marcosbuydid/dc-dc-power-supply/README.md

# Dual DC-DC Power Supply
This is an electronic proyect I started on July 2020 and finish on December 2023.
I began writing the application reports in the last months of 2023 and finish them on December 2024.

## Content
The design is modular, from 1 to 6, each one with a specific function.
In every module folder you will find the schematic and the application report among other files if needed.

## License
All files in this repository are licensed under the terms of the LICENSE file unless stated otherwise.

## Module Folders
Module 1 - Buck-Boost DC/DC Converter

Module 2 - 2 Channel Dual Voltage-Current Meter

Module 3 - Surge-Stopper

Module 4 - 2 Channel Soft-Start

Module 5 - Smart Fan Temperature Controller

Module 6 - Dual Mosfet On-Off Switch

## Copyright © 2020-2026 Marcos Buydid
