marcosbuydid/dc-dc-power-supply/DC:DC Power Supply Modules Connection Diagram.pdf

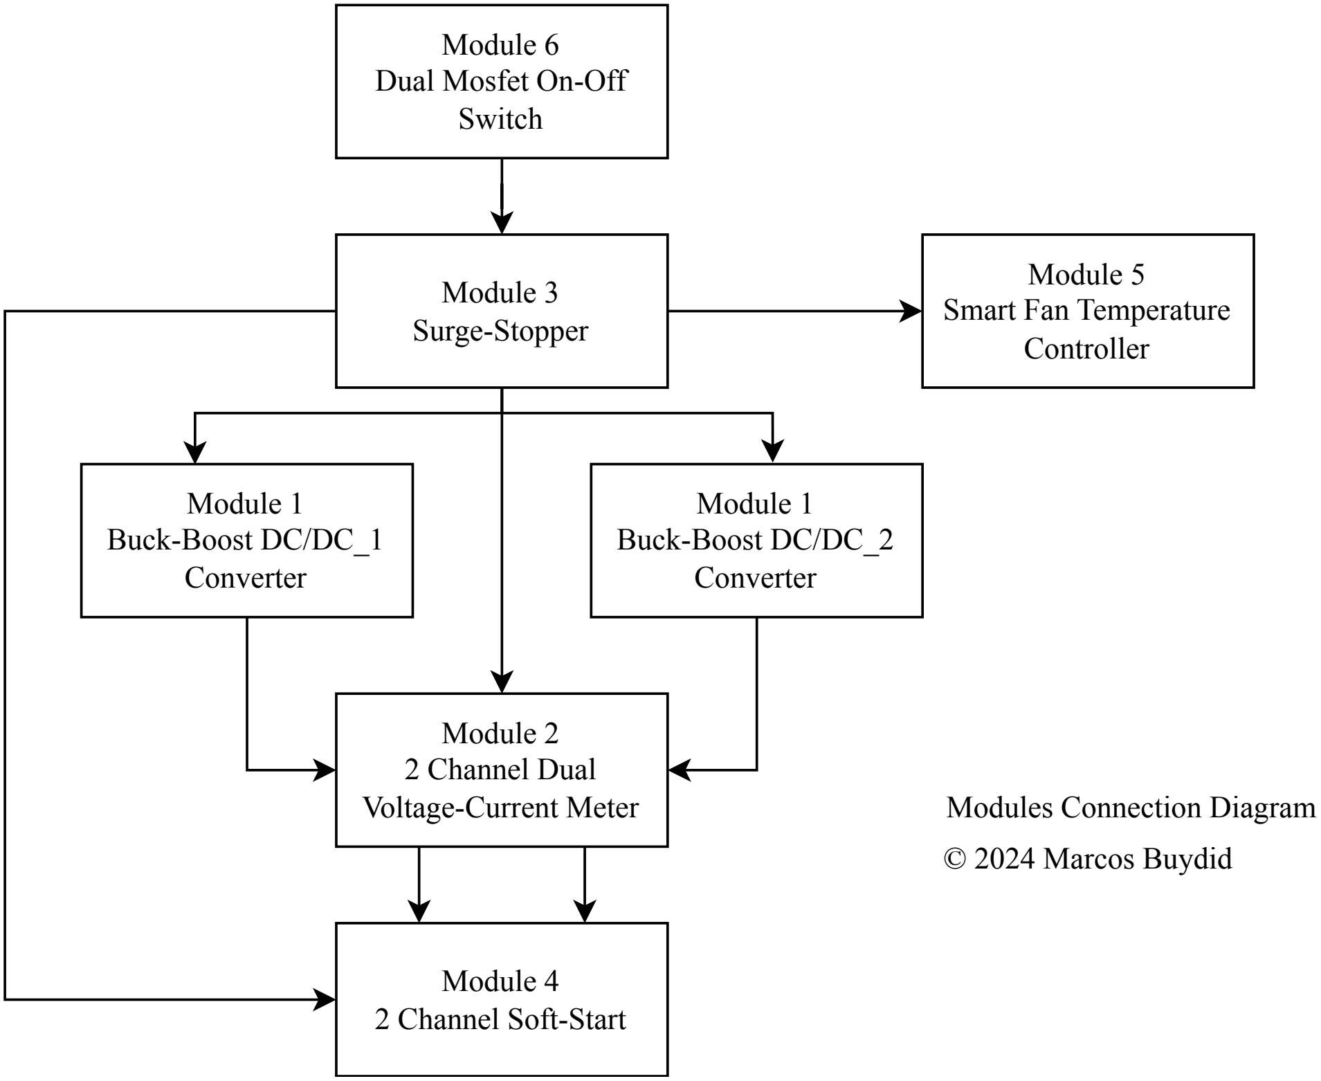
[picture p1: figure]
Module 6 Dual Mosfet On-Off Switch; Module 3 Surge-Stopper; Module 1 Buck-Boost DC/DC_1 Converter; Module 1 Buck-Boost DC/DC_2 Converter; Module 5 Smart Fan Temperature Controller; Module 2 2 Channel Dual Voltage-Current Meter; Module 4 2 Channel Soft-Start; Modules Connection Diagram; © 2024 Marcos Buydid
