marcosbuydid/dc-dc-power-supply/Module_2/2_channel_dual_voltage_current_meter_fw_v1.0.0_Release_Report.xlsx

Sheet: Summary
2 Channel Dual Voltage-Current Meter: firmware v1.0.0 release report
First production release. Compared against v0.3.0. Updated 28 Sep 2026 for the final release file (voltage calibration line, clearer names and comments, debug cycle number).
Release
Firmware file | 2_channel_dual_voltage_current_meter_fw_v1.0.0.ino (final)
Target | Arduino Nano (ATmega328P), Arduino AVR core
Tested binary | The final release file compiles to exactly the build every test suite ran on (production and debug)
Voltage calibration | displayed = measured x 0.99578 + 31 mV, rounded to 10 mV: 0.790-20.110 V, then OL
Verdict | Ready for release: no failures in any simulated test; bench voltage check agrees with a Fluke 15B+
Release condition | Release after the remaining Bench Test Plan checks pass
Simulated tests (v1.0.0)
Test cases | 102
Passed | 99
Failed | 0
Observations | 3 | Behavior kept from v0.3.0 on purpose; see Findings.
Unit tests (functions called directly on the chip)
Unit test cases | 234322
Mismatches against the models | 0 | Must be 0.
Parity with v0.3.0 (every ADC code 0-1023)
Voltage: identical | 595
Voltage: within 10 mV (calibration line) | 423 | The line replaces the 7 offset bands; mean difference 0.0 mV.
Voltage: -20 mV at the end of the old +30 mV band | 3 | 4.13-4.17 V: the old band over-corrected there.
Voltage: low range fixed (0.82, 0.84 V) | 2 | v0.3.0 showed 0.790 / 0.800 here and ran backwards.
Voltage: ADC full scale now OL | 1
Current: identical | 852
Current: +0.01 A (nearest step) | 58 | v1.0.0 picks the closer table value; v0.3.0 leaned to the lower one.
Current: gap bug fixed (2.49/2.50 A) | 2
Current: above 5.00 A now OL | 112
Unexplained differences | 0 | Must be 0.
Findings
Open: check on bench | 4
Open: recommendations | 6
Fixed in the final file | 4 | F-02, F-03 (calibration line), F-10 (parameter renamed) and F-11 (comments).
Stability (display changes in 1,500 noisy cycles)
v0.3.0 | 528
v1.0.0 | 4
Reduction | 99.2%
Voltage accuracy
Estimated spec | ±(0.1 % + 2 digits) | Error budget on the Voltage Accuracy sheet; 1 digit = 10 mV.
Fluke 15B+ points inside its tolerance | 10 of 10
Largest difference where the Fluke can decide (mV) | #VALUE! | Below 4 V; above 4 V a better reference is needed (F-13, BT-49).
Keysight E36312A vs this meter at 12 V | 0.24x | About 4x more accurate; Siglent SPD3303X-E is about 2.5x less accurate.
Memory and timing (v1.0.0 production build)
Flash | 9358 | bytes
Free RAM at peak | 1565 | bytes
Free RAM at peak, v0.3.0 | 596 | bytes
Measurement work per 560 ms cycle | 42.7 | ms (typical)
Worst-case measurement work | 56.6 | ms (samples in worst order for sorting)
Bench test plan (fill in on the hardware)
Passed | 0
Failed | 0
Not done yet | 49
Before flashing a production unit
1. Confirm DEBUG_FLAG is 0 in the file you flash.
2. Check the board uploads with Processor "ATmega328P" (Optiboot). Old bootloader + watchdog can reset endlessly.
3. Keep VOLTAGE_CAL_GAIN 0.99578 and VOLTAGE_CAL_OFFSET_MV 31.0 unless BT-49 with a better reference shows otherwise.
4. Run the Bench Test Plan, including BT-43 (outlier rejection on your real load) and BT-49 (voltage 5-20 V).
Sheets in this workbook
Changes | Every modification from v0.3.0 to v1.0.0
Enhancements | Improvements with measured numbers
Test Cases | 102 test cases with v0.3.0 and v1.0.0 results
Unit Tests | Function-by-function results
ADC Parity | All 1,024 ADC codes, voltage, current, LED and LCD row
Stability Tests | Noise, dropout and ramp tests; outlier rejection limits
LCD Scenarios | Exact LCD rows in over range, LED, alert and crosstalk events
Findings | Open and closed findings for v1.0.0
Memory & Timing | Flash, RAM, stack, cycle time, watchdog margin
Bench Test Plan | Hardware checks to fill in
Voltage Accuracy | Fluke 15B+ bench check, error budget, comparison with commercial supplies
Method | How everything was tested

Sheet: Changes
Modifications from v0.3.0 to v1.0.0
v0.3.0 = 2_channel_dual_voltage_current_meter_fw_v0.3.0.ino. v1.0.0 = 2_channel_dual_voltage_current_meter_fw_v1.0.0.ino.
ID | Area | Type | v0.3.0 behavior | v1.0.0 behavior | User visible | Verified by
CH-01 | Current | Bug fix | Linear search in two halves; 2.219-2.228 V (2.49-2.50 A) fell in neither half | Binary search over the whole table | Yes | C-03
CH-02 | Current | Behavior change | Picks the lower step unless the reading is > 5 mV above it | Picks the truly nearest step (58 of 912 codes show +0.01 A) | Yes | C-02, C-05
CH-03 | Current | Bug fix | Above 5.00 A returns 999.23: display "999.2A0", LED off | "OL" in the current field, LED on | Yes | C-04, L-03
CH-04 | Voltage | Enhancement | ADC full scale shows 20.130 V | "OL" in the voltage field | Yes | V-02
CH-05 | ADC | Enhancement | 1 sample per reading | 64 samples per channel (16 for temperature), fractional average | Yes (stability) | V-06 to V-08, C-07, C-08
CH-06 | ADC | Enhancement | None | Outlier rejection: samples > 8 counts from the median are ignored | Yes (dropouts) | A-07 to A-09
CH-07 | ADC | Enhancement | 1 settling read after a channel switch | 2 settling reads | No | A-03, A-06
CH-08 | ADC | Enhancement | Fixed sample timing | 0-7 us random jitter between samples | No | A-04
CH-09 | Display | Enhancement | None | Hysteresis: 3 mV on voltage steps, 1.5 mV on current steps | Yes (no flicker) | V-07, V-09, C-07
CH-10 | Display | Enhancement | n/a | Hysteresis cleared at startup, over range, below 0.790 V and on alert changes | No | T-05
CH-11 | Temperature | Enhancement | Alert on and off at 0.680 V (toggles near threshold) | On at 0.680 V, off below 0.670 V | Yes | T-02, T-03
CH-12 | Display | Bug fix | Alert screen cleared every cycle (flicker); leftovers "-T"/"LE" after the alert | Alert drawn once; screen cleared once on exit | Yes | D-05, D-06
CH-13 | Display | Behavior change | Alert label "IC6-TEMP" | Alert label "VREF-TEMP" | Yes | D-05
CH-14 | Display | Bug fix | Fields printed in pieces; stale "0" in column 15 after an error value | Each row built as a full 16-character line | Yes | D-01, D-02
CH-15 | Display | Behavior change | 4 decimals below 10 V ("5.0300V"), 3 above ("12.030V") | Always 3 decimals, right-aligned (" 5.030V") | Yes | D-04
CH-16 | Timing | Enhancement | delay(10) + delay(550): real period about 573 ms | millis() scheduler: exactly 560 ms, rollover safe | No | S-01 to S-03
CH-17 | Reliability | Enhancement | None | 2 s watchdog; reset cause captured; watchdog disabled early after a reset | Yes (splash message) | W-01, W-02
CH-18 | Startup | Enhancement | Analog pins INPUT only | DIDR0 buffers off, unused pins pulled up, D13 and LEDs LOW, reference selected first | No | I-01 to I-06
CH-19 | Startup | Bug fix | pinMode(A6) outside the pin tables | Removed | No | I-07
CH-20 | Memory | Enhancement | Lookup table in RAM (1,319 B static RAM) | Table in flash (PROGMEM), strings in flash (F()): 273 B static RAM | No | M-01, M-02
CH-21 | Serial | Enhancement | Serial.begin(9600) with no output | No serial in production; debug build at 115200 with per-cycle diagnostics | No | G-01
CH-22 | Code | Refactor | Globals per channel, magic numbers, 999.23 sentinel | Channel struct, Reading/ReadingStatus, named constexpr constants, prototypes, static_asserts | No | B-01, B-04
CH-23 | Startup | Refactor | lcd.begin() called twice | Called once; splash text unchanged | No | I-08
CH-24 | Voltage | Calibration | 7 offset bands (+30 to -40 mV) added after truncating to 10 mV; special low range (0.790 / 0.810 V below 0.800 V) | One calibration line: displayed = measured x 0.99578 + 31 mV (fit of the same bands), rounded to the nearest 10 mV; 0.000 below 0.790 V. Constants VOLTAGE_CAL_GAIN / VOLTAGE_CAL_OFFSET_MV (1.0 / 0.0 = no compensation). 410 B less flash. | Yes (within 10 mV; no backwards steps) | V-01, V-04, V-05, V-09, V-11, V-12
CH-25 | Code | Refactor | Names: captureResetFlags, calculateChannelMeasurements, showTemperatureAlert, REFRESH_MEASUREMENT_PERIOD_MS, CURRENT_TO_VOLTAGE_TABLE_LAST, voltageSenseMv (parameter), temperatureVoltage | captureResetFlagsAndDisableWatchdog, calculateAndDisplayChannelMeasurements, showVRefTemperatureAlert, MEASUREMENT_PERIOD_MS, CURRENT_TO_VOLTAGE_TABLE_LAST_INDEX, currentSenseMv, vRefTemperatureVoltage. Comments reworded (lines 18, 159-161, 213, 465, 569, 591-593). Production binary unchanged | No | R-03, B-05
CH-26 | Serial | Enhancement | Debug lines without a cycle reference | Debug build: every line starts with "#n" (debugCycleCount, +1 per 560 ms cycle, restarts at 1 after a reset). Debug build only: +0.2 ms per cycle, +118 B flash, +4 B RAM | Debug only | G-01, B-02

Sheet: Enhancements
What v1.0.0 improves, with measured evidence
All figures are measured in the simulation runs (see Method). Improvement columns are formulas.
Enhancement | Metric | v0.3.0 | v1.0.0 | Improvement | Evidence
Stable voltage display | Display changes, 10 mV boundary (ADC 611.40), 300 cycles | 158 | 3 | 98.10126582% fewer | V-07
Stable voltage display | Display changes inside a step (ADC 611.15), 300 cycles | 188 | 0 | 100% fewer | V-08
Stable current display | Display changes, 0.01 A boundary, 300 cycles | 142 | 1 | 99.29577465% fewer | C-07
Stable current display | Display changes inside a step, 300 cycles | 30 | 0 | 100% fewer | C-08
Dropout immunity | Cycles showing 0.02 A with 2% dropouts, of 300 | 5 | 0 | 100% fewer | A-07
Voltage resolution | Distinct displayed voltages reachable | 984 | 1934 | 2.0x | V-06, V-11; fine sweep
Correct current in 2.49-2.50 A | ADC codes showing an error value | 2 | 0 | 100% fewer | C-03
Clear over-range display | Codes showing garbage "999.2A0" | 112 | 0 | 100% fewer | C-04
Clean LCD rows | Sweep steps with a leftover character | 569 | 0 | 100% fewer | D-01
No alert flicker | Screen clears per alert cycle | 1 | 0 | 100% fewer | D-05
Alert hysteresis | Alert state changes while hovering 0.684/0.679 V after the alert is on (3 cycles) | 3 | 0 | 100% fewer | T-03
Crosstalk margin | Contaminated reads tolerated after a channel switch | 1 | 2 | 2.0x | A-05, A-06
RAM headroom | Free RAM at peak stack (bytes) | 596 | 1565 | 2.6x | M-02
Timing precision | Measurement period (ms) | 573 | 560 | Exactly 560 ms (was 573 ms) | S-01, S-03
Self-recovery | Time to recover from a firmware hang (ms) | Never (hangs) | 2029 | Recovers automatically | W-01
Smooth voltage calibration | Places where a rising voltage makes the display step back (fine sweep) | 2 | 0 | 100% fewer | V-09, F-02, F-03
Improvement = 1 - v1.0.0 / v0.3.0 for "fewer" rows, v1.0.0 / v0.3.0 for "x" rows.

Sheet: Test Cases
Test cases and results
Results for v1.0.0 and v0.3.0. Source: simulated ATmega328P test runs (see Method).
ID | Group | Test | Stimulus | Expected (v1.0.0) | v0.3.0 result | v1.0.0 result | Status | Method
B-01 | Build | Production build compiles (DEBUG_FLAG 0) | avr-gcc 7.3.0, strict C++ (no IDE auto-prototypes), -Wall -Wextra | No errors, no warnings | Compiles only with IDE auto-prototypes | No errors, no warnings. 9,358 B flash, 273 B SRAM | PASS | Compiler
B-02 | Build | Debug build compiles (DEBUG_FLAG 1) | Same, DEBUG_FLAG 1 | No errors, no warnings | n/a (no debug mode) | No errors, no warnings. 10,476 B flash, 291 B SRAM (cycle number added to debug output) | PASS | Compiler
B-03 | Build | Release file is set to production | Check DEBUG_FLAG in the file to be flashed | DEBUG_FLAG 0 | n/a | DEBUG_FLAG 0 | PASS | Code review
B-04 | Build | Compile-time checks | static_assert: table size 501, alert OFF < ON, sample counts <= 64 | All hold | None present | All hold | PASS | Compiler
I-01 | Startup | External reference selected before first ADC read | Record order of analogReference / analogRead | analogReference(EXTERNAL) before any analogRead | OK (set in setup, reads in loop) | OK (first line of setup) | PASS | Simulation
I-02 | Startup | Analog inputs A0-A3 configured | Record pinMode calls | INPUT, no pull-up | INPUT | INPUT | PASS | Simulation
I-03 | Startup | Digital input buffers off on A0-A3 | Read DIDR0 after setup | DIDR0 = 0x0F | DIDR0 = 0x00 | DIDR0 = 0x0F | PASS | Simulation
I-04 | Startup | LED pins D3/D5 | Record pinMode / digitalWrite | OUTPUT, LOW at start | OUTPUT (default LOW) | OUTPUT, explicitly LOW | PASS | Simulation
I-05 | Startup | Unused pins D2, D4, D6, A4, A5 | Record pinMode | INPUT_PULLUP (not floating) | Not configured (floating) | INPUT_PULLUP | PASS | Simulation
I-06 | Startup | On-board LED D13 | Record pinMode / digitalWrite | OUTPUT, LOW | Not configured | OUTPUT, LOW | PASS | Simulation
I-07 | Startup | No pinMode() on A6 (pin 20) | Record pinMode calls; inspect pin tables in the binary | Not called (A6 is analog-only, outside Arduino pin tables) | Called: reads past pin table (no effect in this build) | Not called | PASS | Simulation + binary inspection
I-08 | Startup | Splash screen | Capture LCD during the 2 s splash | "STARTING" / "PLEASE WAIT" | | STARTING | PLEASE WAIT | | | STARTING | PLEASE WAIT | | PASS | Simulation
I-09 | Startup | Splash after a watchdog reset | Force a hang, capture splash on reboot | "WATCHDOG RESET" on row 2 | n/a (no watchdog) | | STARTING | WATCHDOG RESET | | PASS | Simulation
A-01 | ADC | Conversions per measurement cycle | Count analogRead calls in one cycle | 282 = 18 temperature + 4 x 66 | 10 (2 per pin) | 282 (A6 18, A0-A3 66 each) | PASS | Simulation
A-02 | ADC | Channel read order | Record pin sequence | A6, A3, A2, A0, A1 (same as v0.3.0) | A6, A3, A2, A0, A1 | A6, A3, A2, A0, A1 | PASS | Simulation
A-03 | ADC | Settling reads after channel switch | Count discarded reads | 2 per switch | 1 per switch | 2 per switch | PASS | Simulation
A-04 | ADC | Sample jitter distribution | Histogram of delayMicroseconds() arguments over the full run | Uniform 0-7 us | n/a | 0-7 us, each value 12.5% (219,884-219,971 per bin) | PASS | Simulation
A-05 | ADC | Crosstalk: 1 contaminated read after switch | Model: first read after a switch returns previous channel value | Correct reading | Correct | Correct | PASS | Simulation (model)
A-06 | ADC | Crosstalk: 2 contaminated reads after switch | Model: first 2 reads return previous channel value | Correct reading | Wrong: shows 0.0000V / 0.000A | Correct: 17.700V / 0.720A | PASS | Simulation (model)
A-07 | ADC | Single-sample dropouts (original symptom) | 0.72 A, ±0.5 count noise, 2% of samples drop to 0.02 A, 300 cycles | Steady 0.720A | 0.02A shown in 5 of 300 cycles | 0.720A in all 300 cycles (with outlier rejection off, OUTLIER_LIMIT_COUNTS = 1023: 215 display changes, 0.65-0.72 A) | PASS | Simulation
A-08 | ADC | Outlier rejection disabled (limit 1023) | Full test run with OUTLIER_LIMIT_COUNTS = 1023 | Identical to a plain average of all samples | n/a | 6,473 of 6,473 rows identical to a plain-average build of the final file | PASS | Simulation
A-09 | ADC | Outlier rejection is neutral for normal signals | All sweeps, ramps, noise, OL, LED, temperature, crosstalk tests | Identical to plain average | n/a | All rows identical except the 300-cycle dropout test (A-07) | PASS | Simulation
V-01 | Voltage | Full ADC sweep, codes 0-1022, parity with v0.3.0 | Each code, fresh state, both channels | Within 10 mV of v0.3.0 except the intended fixes | Reference | 595 identical, 423 within ±10 mV (line instead of bands), 3 at -20 mV (4.13-4.17 V, end of the old +30 mV band), 2 low-range fixes (codes 40-41), 1 OL | PASS | Simulation
V-02 | Voltage | ADC full scale (code 1023) | Voltage ADC saturated | "OL" | 20.130V (not a real value) | OL | PASS | Simulation
V-03 | Voltage | Independent model check | Python float32 re-implementation of both algorithms (v0.3.0 offset bands, v1.0.0 calibration line) | Both firmwares match their model | Matches 1024/1024 | Matches 1023/1023 codes, plus all 51,151 points of a fine sweep (ADC 0-1023 in 0.02 steps) | PASS | Simulation + model
V-04 | Voltage | Low range near 0.790 V | Codes 0-45 | 0.000 below 0.790 V (after calibration), then only rising values | Codes 38-41: 0.000, 0.790, 0.790, 0.800; runs backwards at 0.800 V (F-02) | Codes 38-42: 0.000, 0.800, 0.820, 0.840, 0.860; always rising | PASS | Simulation
V-05 | Voltage | Calibration line | VOLTAGE_CAL_GAIN 0.99578, VOLTAGE_CAL_OFFSET_MV 31.0, whole range | Smooth correction: +27 mV at 1 V to -53 mV at 20 V, no band steps | 7 offset bands, +30 to -40 mV | Matches the model at every point. Versus v0.3.0: mean 0.0 mV, 99.7% of fine-sweep points within ±10 mV | PASS | Simulation
V-06 | Voltage | Resolution on a slow ramp | Codes 200-260 (3.9-5.1 V) in 0.1 steps, up and down | All 118 10 mV values | 59 changes (skips every other 10 mV value) | 117 changes (every 10 mV value, 3.960-5.130 V); never more than 10 mV from ideal | PASS | Simulation
V-07 | Voltage | Stability on a 10 mV boundary | ADC 611.40 (12.035 V after calibration, exactly on a step boundary), ±1 count noise, 300 cycles | Few display changes | 158 changes (12.01/12.03/12.05) | 3 changes (12.03/12.04) | PASS | Simulation
V-08 | Voltage | Stability inside a step | ADC 611.15 (12.030 V), ±1 count noise, 300 cycles | No display changes | 188 changes | 0 changes | PASS | Simulation
V-09 | Voltage | Hysteresis correctness | 2,886 ramp cycles (simulation), 40,922-step function ramp ADC 0-1023 up and down, 96,962 unit cases | Never more than 1 step from nearest value; never moves against the input | n/a | Max 1 step (0.01 V); 0 reversals anywhere (F-02 and F-03 closed) | PASS | Simulation + model
V-10 | Voltage | Channel 2 identical to channel 1 | Same input on both channels, all sweeps | Identical rows | Identical | Identical | PASS | Simulation
C-01 | Current | Full ADC sweep, parity with v0.3.0 | Codes 0-1023, fresh state | Same as v0.3.0 except intended fixes | Reference | 852 identical, 58 +0.01 A, 2 gap fixed, 112 OL | PASS | Simulation
C-02 | Current | Rounding to nearest 0.01 A step | 58 codes where v0.3.0 rounds down | Nearest table step | Lower step (5 mV rule) | Nearest step (+0.01 A vs v0.3.0) | PASS | Simulation + model
C-03 | Current | 2.49-2.50 A gap | Codes 455 and 456 | 2.490A and 2.500A | 999.2A0 (error value) | 2.490A and 2.500A | PASS | Simulation
C-04 | Current | Above 5.00 A | Codes 912-1023 | "OL" | 999.2A0 (garbage), LED off | OL, LED on | PASS | Simulation
C-05 | Current | Independent model check | Python nearest-step model | Match | n/a | 1024 of 1024 | PASS | Model
C-06 | Current | Slow ramp 0.49-0.78 A | Codes 100-160 in 0.1 steps, up and down | Monotonic, max 1 step from nearest | Monotonic, max 0.01 A | Monotonic, max 0.01 A | PASS | Simulation
C-07 | Current | Stability on a 0.01 A boundary | 0.71/0.72 A boundary, ±1 count noise, 300 cycles | Few display changes | 142 changes | 1 change | PASS | Simulation
C-08 | Current | Stability inside a step | 0.72 A, ±1 count noise, 300 cycles | No display changes | 30 changes (0.72/0.73) | 0 changes | PASS | Simulation
C-09 | Current | Channel 2 identical to channel 1 | Same input on both channels | Identical rows | Identical | Identical | PASS | Simulation
D-01 | Display | No leftover characters in normal rows | Current sweep 0-1023 | Column 15 always blank | "0" left in column 15 in 569 of 1024 steps | Blank in 1024 of 1024 | PASS | Simulation
D-02 | Display | Return from current over range | OL then 0.72 A | "0.720A" clean | "0.720A0" | "0.720A" | PASS | Simulation
D-03 | Display | Voltage over range | ADC 1023 | "OL" in voltage field | "20.130V" | " OL" | PASS | Simulation
D-04 | Display | Row format | All tests | 16 characters, 3 decimals | "5.0300V" below 10 V, "12.030V" above | " 5.030V" / "12.030V", always 3 decimals | PASS | Simulation
D-05 | Display | Temperature alert screen | Temperature 0.684 V | Alert text, drawn once | "IC6-TEMP" / "ALERT", screen cleared every cycle (flicker) | "VREF-TEMP" (column 4, as v0.3.0) / "ALERT", cleared once on entry | PASS | Simulation
D-06 | Display | Screen after the alert ends | Temperature back to 0.645 V | Clean measurement rows | Leftover "-T" and "LE" from alert text | Clean (cleared once on exit) | PASS | Simulation
L-01 | LED | LED at 0.00 A | Current code 0 and 1 | Off | Off | Off | PASS | Simulation
L-02 | LED | LED at 0.01-5.00 A | Current codes 2-911 | On | On | On | PASS | Simulation
L-03 | LED | LED above 5.00 A | Current codes 912-1023 | On (current is flowing) | Off | On | PASS | Simulation
L-04 | LED | LEDs during temperature alert | Alert active | Documented behavior | Keep last state | Keep last state (unchanged from v0.3.0) | OBSERVATION | Simulation
T-01 | Temperature | Alert turns on | Temperature code 140 (0.684 V) | Alert on at >= 0.680 V | On | On | PASS | Simulation
T-02 | Temperature | Alert hysteresis | Codes 139, 138 after alert | Stays on until < 0.670 V | Turns off at 139 (0.679 V) | Stays on at 139/138; off at 137 (0.669 V) | PASS | Simulation
T-03 | Temperature | Hovering at the threshold | Alternating codes 140/139 | No toggling | Toggles every cycle | Stays in alert | PASS | Simulation
T-04 | Temperature | Measurements pause during alert | Count ADC reads during alert | Only temperature is read | Channels read but not shown | 18 reads (temperature only) | PASS | Simulation
T-05 | Temperature | Hysteresis state reset after alert | Alert on then off | Previous steps cleared | n/a | Cleared (NO_STEP) | PASS | Code review + simulation
S-01 | Timing | Refresh period | loop() at +100, +559, +560 ms | Measure only at +560 ms | n/a (delay based) | 0, 0, 282 reads | PASS | Simulation
S-02 | Timing | millis() rollover (49.7 days) | Last measurement 0xFFFFFE00, now 0xFFFFFFF0 then 0x00000030 | No measurement at 496 ms, measurement at 560 ms | n/a | Correct | PASS | Simulation
S-03 | Timing | Measurement cycle work time | Real firmware, real ADC timing and LCD library | Well under 560 ms | 13 ms work + 560 ms delays = 573 ms period | 42.7 ms work, 560 ms period (debug build 47.4 ms) | PASS | Simulation (real firmware)
W-01 | Watchdog | Recovery from a firmware hang | Infinite loop inside analogRead(A2) | Reset within ~2 s, normal operation after | n/a (hangs forever) | Reset after 2,029 ms; reset flags 0x08; normal readings after reboot | PASS | Simulation
W-02 | Watchdog | No spurious resets | Full test run, about 6,500 cycles | No unexpected reset | n/a | None | PASS | Simulation
M-01 | Memory | Static RAM | Compiler report | Low | 1,319 B (64%) | 273 B (13%) | PASS | Compiler
M-02 | Memory | Peak stack | RAM painting, real firmware | Enough free RAM | 133 B, 596 B free | 210 B, 1,565 B free | PASS | Simulation (real firmware)
B-05 | Build | Release file compiles to the tested binary | Compare compiled binaries byte by byte | Identical binaries | n/a | Production binary of the final file (with renames and comment fixes) is byte-for-byte identical to the tested release (9,358 B). Debug binary identical to the build every debug test ran on | PASS | Compiler
B-06 | Build | Extra compiler warnings | -Wshadow -Wpedantic -Wcast-qual -Wdouble-promotion -Wundef -Wuninitialized -Wlogical-op -Wduplicated-cond | No real issues | n/a | Only -Wdouble-promotion on fabs() (lines 500, 541): double = float on AVR, no effect (F-09) | PASS | Compiler
B-07 | Build | Static analysis | cppcheck 2.13 --enable=all --inconclusive, debug build | No defects | n/a | No defects (only "setup/loop/captureResetFlagsAndDisableWatchdog never used": called by the Arduino core and startup code) | PASS | Static analysis
B-08 | Build | Compile-time checks block bad settings | Break each check on purpose: 65 samples, 0 samples, alert OFF > ON, table with 500 entries | Build fails with a clear message | n/a | All 4 builds fail with their own message ("Too many samples", "At least one sample", ...) | PASS | Compiler
R-01 | Regression | Full system bench on the final release file | Same 6,473-row run, compared with the previous v1.0.0 build (7-band voltage table) | Only the voltage values change, as intended | n/a | Current, LEDs, screen clears and ADC read counts identical in all 6,473 rows. Voltage differs only where the calibration line changes it; all 2,048 sweep values match the model. Alert text at column 4, as v0.3.0 | PASS | Simulation
R-02 | Regression | Unit, edge and timing suites on the final file | Unit (125,583 lines), edge (3,445 lines), fine voltage sweep and ramps, timing on the real firmware | All pass | n/a | 0 mismatches in every suite; timing 42.7 ms per cycle, peak stack 210 B | PASS | Simulation
U-01 | Unit: averaging | All samples equal | All 0, all 1023, all 500 | Exact value | n/a | 0.0000, 1023.0000, 500.0000 | PASS | Unit test
U-02 | Unit: averaging | Sorting | Ascending 0-63 and descending 63-0 | Same result | n/a | 32.0000 both | PASS | Unit test
U-03 | Unit: averaging | Dropouts and spikes rejected | 62x131 + 2x4; 60x131 + 4x1023 | 131 | n/a | 131.0000 both | PASS | Unit test
U-04 | Unit: averaging | Rejection limit exactly 8 counts | 60x500 + 2x508 + 2x509; 60x500 + 2x492 + 2x491 | 508/492 kept, 509/491 dropped | n/a | 500.2581 and 499.7420 (exact expected values) | PASS | Unit test
U-05 | Unit: averaging | Two levels (load step inside the window) | 32x100 + 32x200; 33x100 + 31x200 | Majority level | n/a | 200.0000 and 100.0000 | PASS | Unit test
U-06 | Unit: averaging | Normal noise equals plain mean | 64 random samples 128-135 | Plain mean 131.65625 | n/a | 131.6562 | PASS | Unit test
U-07 | Unit: averaging | Temperature (16 samples) | 14x139 + 2x0 | 139 | n/a | 139.0000, 18 reads | PASS | Unit test
U-08 | Unit: averaging | Sample count above 64 is capped | Request 100 samples | 64 used, no array overflow | n/a | 300.0000, 66 reads (2 settling + 64) | PASS | Unit test
U-09 | Unit: averaging | Sample count 1 and 0 | Request 1 and 0 samples | 1: the sample; 0: not used by firmware | n/a | 1: 777.0000. 0 is blocked at compile time (static_assert "At least one sample") | PASS | Unit test
U-10 | Unit: voltage | computeVoltage() at every step boundary | Steps 79-2017 (0.785-20.165 V) x 10 offsets (-3.1 to +5 mV) x 5 previous states, plus OL and 0.790 V threshold edges | Matches float32 model | n/a | 96,962 cases, 0 mismatches | PASS | Unit test + model
U-11 | Unit: current | computeCurrent() at every table midpoint and entry | 500 intervals x 10 offsets (±1.6 mV) x 5 previous states + OL edges | Matches float32 model | n/a | 25,001 cases, 0 mismatches | PASS | Unit test + model
U-12 | Unit: current | findNearestCurrentStep() | 0 to 4,451 mV in 0.25 mV steps | Nearest table entry | n/a | 17,805 cases, 0 mismatches | PASS | Unit test + model
U-13 | Unit: display | formatChannelRow() for every reachable value | 0.000 and all 1,933 values 0.790-20.110 V, all 501 current values, 3 OL combinations | Exact 16-character rows, terminated | n/a | 2,438 rows, 0 mismatches | PASS | Unit test + model
U-14 | Unit: voltage | 0.790 V display threshold | ADC 38.600 / 38.650 / 38.658 / 38.660 / 38.670 / 38.700 | 0.000 below 790 mV after calibration (ADC 38.659), 0.790 from there | n/a | 0.000, 0.000, 0.000, 0.790, 0.790, 0.790 | PASS | Unit test + model
U-15 | Unit: voltage | Rounding to the nearest 10 mV | Every step boundary ±0.01 mV, no previous state | Halfway values round up (v0.3.0 truncated) | n/a | Part of U-10: 0 mismatches | PASS | Unit test + model
U-16 | Unit: temperature | Alert logic at the thresholds | 0.669999 / 0.67 / 0.679999 / 0.68 V from both states | On at 0.680, off below 0.670 | n/a | 16 cases, 0 mismatches | PASS | Unit test
U-17 | Unit: hysteresis | isAdjacentStep() | NO_STEP, equal, ±1, ±2, extremes | Adjacent only for ±1 | n/a | 12 cases, 0 mismatches | PASS | Unit test
U-18 | Unit: hysteresis | Hold never exceeds one step | All cases in U-10 and U-11 | Max 1 step from natural value | n/a | Held in 10,337 voltage and 2,639 current cases, always exactly 1 step | PASS | Unit test
E-01 | Edge | Channel independence | One channel changes every cycle, the other fixed, both ways | Fixed channel never changes | n/a | 122 cycles: 0 changes on the fixed channel, 0 value mismatches | PASS | Simulation
E-02 | Edge | Large load steps | 0 -> 3.37 A -> 0 -> 4.89 A, 5 -> 12 -> 19.66 V | Shown in the same cycle | n/a | Shown immediately (hysteresis only acts on 1-step changes) | PASS | Simulation
E-03 | Edge | Noise at voltage full scale | ADC 1022.5 ±1 count, 100 cycles | Documented behavior | n/a | Alternates OL / 20.100-20.110V (50 changes). Outside the 0.8-20 V rating (F-04) | OBSERVATION | Simulation
E-04 | Edge | Noise at the 5.00 A limit | ADC 911.12 ±1 count, 100 cycles | Documented behavior | n/a | Alternates 5.000A / OL (48 changes). Outside the 4 A rating (F-04) | OBSERVATION | Simulation
E-05 | Edge | LED at the 0.00/0.01 A boundary | 6 mV ±1 count noise, 100 cycles | LED matches display | n/a | 0 inconsistencies, 0 display changes | PASS | Simulation
E-06 | Edge | Power-on with the alert already active | Temperature 0.689 V at boot | Alert on first cycle, LEDs off, clean return | n/a | Alert on first cycle, LEDs off, clean rows after cooling | PASS | Simulation
E-07 | Edge | Alert during over range | OL on CH1, then alert, then back | OL shown again after alert | n/a | Correct | PASS | Simulation
E-08 | Edge | Watchdog register state | Read WDTCSR during splash and after setup | Off during splash, 2 s after setup | n/a | During splash 0x00, after setup 0x0F | PASS | Simulation
E-09 | Edge | Irregular loop() calls | loop() every 1 ms and every 9 ms for 20 s | No measurement before 560 ms | n/a | Every 1 ms: all intervals 560 ms. Every 9 ms: all 567 ms (next call after 560) | PASS | Simulation
E-10 | Edge | Random soak | 3,000 cycles, random inputs, noise, dropouts, random temperature | Valid rows, correct LEDs and alert state | n/a | 347 alert cycles; 0 format, LED, alert-state or read-count errors | PASS | Simulation
E-11 | Edge | Worst-case sorting time | Samples in reverse order (worst case for insertion sort) | Well inside 560 ms and 2 s watchdog | n/a | +3.5 ms per 64-sample channel; worst-case cycle about 57 ms (see Memory & Timing) | PASS | Simulation
G-01 | Debug output | Serial Monitor format | DEBUG_FLAG 1: normal, OL, alert and watchdog-reset cycles; full system bench on the debug build | Each line starts with the cycle number; one temperature line then one line per channel | n/a | "#n" on every line; +1 per cycle, also during an alert (temperature line only); numbers 1-6,480 with no gaps; back to #1 after a watchdog reset. LCD, LEDs and watchdog identical to production in all 6,473 rows. 115200 baud | PASS | Simulation
V-11 | Voltage | Displayed range | Fine sweep ADC 0-1023 (0.02 steps) | 0.790 V up to the top of the ADC range, then OL | 0.790-20.130 V, never OL | 0.790-20.110 V; OL from ADC 1022.5 (20.160 V measured) | PASS | Simulation + model
V-12 | Voltage | Bench check against a Fluke 15B+ | 10 points 0.8-20 V on the real supply, final firmware | Every difference inside the Fluke tolerance | n/a | All 10 inside. Below 4 V (Fluke 1 mV range): -7 to -2 mV. Above 4 V the Fluke is not precise enough to decide (F-13) | PASS | Bench (hardware)
R-03 | Regression | Refactored file: names, comments and debug cycle number | Renames (captureResetFlagsAndDisableWatchdog, calculateAndDisplayChannelMeasurements, showVRefTemperatureAlert, MEASUREMENT_PERIOD_MS, CURRENT_TO_VOLTAGE_TABLE_LAST_INDEX, currentSenseMv, vRefTemperatureVoltage), comment fixes and debugCycleCount | Same results as the tested v1.0.0 | n/a | Production binary byte-identical. System (6,512 lines), unit (125,581), edge/soak (3,443) and voltage sweep/ramp (92,077) outputs identical line for line; timing and stack unchanged | PASS | Compiler + simulation

Sheet: Unit Tests
Unit tests: each firmware function called directly on the simulated chip
Every result compared with an independent float32 model of the intended behavior. Run on the release file.
Function | What was tested | Cases | Mismatches | Result
readAdcAverage() | Scripted sample sets: equal values, sort order, dropouts, spikes, limit 8/9 counts, two levels, random noise, 16 samples, 100 -> 64 cap, 1 sample | 15 | 0 | PASS
computeVoltage() | Every 10 mV step boundary (steps 79-2017) x offsets -3.1..+5 mV x previous state (none, -2, -1, same, +1), plus OL and 0.790 V threshold edges | 96962 | 0 | PASS
computeCurrent() | Every table midpoint and entry x offsets ±1.6 mV x previous state, plus 4451 mV / ADC 911-912 OL edges | 25001 | 0 | PASS
findNearestCurrentStep() | 0 to 4,451 mV in 0.25 mV steps against a plain nearest-value search | 17805 | 0 | PASS
formatChannelRow() | Every reachable voltage (0.000, 0.790-20.110 V) and current value, and all OL combinations | 2438 | 0 | PASS
computeVoltage() fine sweep | ADC 0 to 1023 in 0.02 count steps, fresh state each point, against the float32 calibration-line model | 51151 | 0 | PASS
computeVoltage() ramps | ADC 0 to 1023 and back in 0.05 count steps with the hysteresis state carried over: matches model, 0 reversals, never more than 1 step | 40922 | 0 | PASS
shouldVRefTemperatureAlertBeActive() | Both states x 8 voltages around 0.670 and 0.680 V | 16 | 0 | PASS
isAdjacentStep() | NO_STEP, equal, ±1, ±2 and extreme values | 12 | 0 | PASS
Total |  | 234322 | 0 | PASS
readAdcAverage() with 0 samples would return NaN; the static_assert "At least one sample" prevents it at compile time. Unreachable previous states (current step 501) are excluded.

Sheet: ADC Parity
Full ADC parity: v0.3.0 vs v1.0.0, every code 0-1023
Channel 1 row shown; channel 2 was identical in every step. Inputs are exact (noise-free) ADC codes. Voltage differences come from the calibration line that replaces the 7 offset bands.
ADC counts per volt |  | 204.7 | Op-amp gain |  | 4.036 | Constants from the firmware (ADC_COUNTS_PER_VOLT, OP_AMP_GAIN). v1.0.0 then applies displayed = measured x 0.99578 + 31 mV.
ADC code | ADC pin (mV) | Channel voltage (mV) | v0.3.0 voltage (V) | v1.0.0 voltage (V) | Voltage result | Current sense (mV) | v0.3.0 current (A) | v1.0.0 current (A) | Current result | v0.3.0 LED | v1.0.0 LED | LED result | v0.3.0 LCD row (current sweep) | v1.0.0 LCD row (current sweep)
0 | 0.0 | 0.0 | 0.000 | 0.000 | Identical | 0.0 | 0.00 | 0.00 | Identical | Off | Off | Same | |12.030V 0.000A | | |12.030V 0.000A
1 | 4.9 | 19.7 | 0.000 | 0.000 | Identical | 4.9 | 0.00 | 0.00 | Identical | Off | Off | Same | |12.030V 0.000A | | |12.030V 0.000A
2 | 9.8 | 39.4 | 0.000 | 0.000 | Identical | 9.8 | 0.01 | 0.01 | Identical | On | On | Same | |12.030V 0.010A | | |12.030V 0.010A
3 | 14.7 | 59.1 | 0.000 | 0.000 | Identical | 14.7 | 0.01 | 0.01 | Identical | On | On | Same | |12.030V 0.010A | | |12.030V 0.010A
4 | 19.5 | 78.9 | 0.000 | 0.000 | Identical | 19.5 | 0.02 | 0.02 | Identical | On | On | Same | |12.030V 0.020A | | |12.030V 0.020A
5 | 24.4 | 98.6 | 0.000 | 0.000 | Identical | 24.4 | 0.02 | 0.02 | Identical | On | On | Same | |12.030V 0.020A | | |12.030V 0.020A
6 | 29.3 | 118.3 | 0.000 | 0.000 | Identical | 29.3 | 0.03 | 0.03 | Identical | On | On | Same | |12.030V 0.030A | | |12.030V 0.030A
7 | 34.2 | 138.0 | 0.000 | 0.000 | Identical | 34.2 | 0.03 | 0.03 | Identical | On | On | Same | |12.030V 0.030A | | |12.030V 0.030A
8 | 39.1 | 157.7 | 0.000 | 0.000 | Identical | 39.1 | 0.04 | 0.04 | Identical | On | On | Same | |12.030V 0.040A | | |12.030V 0.040A
9 | 44.0 | 177.4 | 0.000 | 0.000 | Identical | 44.0 | 0.04 | 0.05 | +0.01 A (nearest step) | On | On | Same | |12.030V 0.040A | | |12.030V 0.050A
10 | 48.9 | 197.2 | 0.000 | 0.000 | Identical | 48.9 | 0.05 | 0.05 | Identical | On | On | Same | |12.030V 0.050A | | |12.030V 0.050A
11 | 53.7 | 216.9 | 0.000 | 0.000 | Identical | 53.7 | 0.06 | 0.06 | Identical | On | On | Same | |12.030V 0.060A | | |12.030V 0.060A
12 | 58.6 | 236.6 | 0.000 | 0.000 | Identical | 58.6 | 0.06 | 0.06 | Identical | On | On | Same | |12.030V 0.060A | | |12.030V 0.060A
13 | 63.5 | 256.3 | 0.000 | 0.000 | Identical | 63.5 | 0.07 | 0.07 | Identical | On | On | Same | |12.030V 0.070A | | |12.030V 0.070A
14 | 68.4 | 276.0 | 0.000 | 0.000 | Identical | 68.4 | 0.07 | 0.07 | Identical | On | On | Same | |12.030V 0.070A | | |12.030V 0.070A
15 | 73.3 | 295.7 | 0.000 | 0.000 | Identical | 73.3 | 0.08 | 0.08 | Identical | On | On | Same | |12.030V 0.080A | | |12.030V 0.080A
16 | 78.2 | 315.5 | 0.000 | 0.000 | Identical | 78.2 | 0.08 | 0.08 | Identical | On | On | Same | |12.030V 0.080A | | |12.030V 0.080A
17 | 83.0 | 335.2 | 0.000 | 0.000 | Identical | 83.0 | 0.09 | 0.09 | Identical | On | On | Same | |12.030V 0.090A | | |12.030V 0.090A
18 | 87.9 | 354.9 | 0.000 | 0.000 | Identical | 87.9 | 0.09 | 0.09 | Identical | On | On | Same | |12.030V 0.090A | | |12.030V 0.090A
19 | 92.8 | 374.6 | 0.000 | 0.000 | Identical | 92.8 | 0.10 | 0.10 | Identical | On | On | Same | |12.030V 0.100A | | |12.030V 0.100A
20 | 97.7 | 394.3 | 0.000 | 0.000 | Identical | 97.7 | 0.10 | 0.11 | +0.01 A (nearest step) | On | On | Same | |12.030V 0.100A | | |12.030V 0.110A
21 | 102.6 | 414.0 | 0.000 | 0.000 | Identical | 102.6 | 0.11 | 0.11 | Identical | On | On | Same | |12.030V 0.110A | | |12.030V 0.110A
22 | 107.5 | 433.8 | 0.000 | 0.000 | Identical | 107.5 | 0.12 | 0.12 | Identical | On | On | Same | |12.030V 0.120A | | |12.030V 0.120A
23 | 112.4 | 453.5 | 0.000 | 0.000 | Identical | 112.4 | 0.12 | 0.12 | Identical | On | On | Same | |12.030V 0.120A | | |12.030V 0.120A
24 | 117.2 | 473.2 | 0.000 | 0.000 | Identical | 117.2 | 0.13 | 0.13 | Identical | On | On | Same | |12.030V 0.130A | | |12.030V 0.130A
25 | 122.1 | 492.9 | 0.000 | 0.000 | Identical | 122.1 | 0.13 | 0.13 | Identical | On | On | Same | |12.030V 0.130A | | |12.030V 0.130A
26 | 127.0 | 512.6 | 0.000 | 0.000 | Identical | 127.0 | 0.14 | 0.14 | Identical | On | On | Same | |12.030V 0.140A | | |12.030V 0.140A
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
119 | 581.3 | 2346.3 | 2.370 | 2.370 | Identical | 581.3 | 0.65 | 0.65 | Identical | On | On | Same | |12.030V 0.650A | | |12.030V 0.650A
120 | 586.2 | 2366.0 | 2.390 | 2.390 | Identical | 586.2 | 0.65 | 0.65 | Identical | On | On | Same | |12.030V 0.650A | | |12.030V 0.650A
121 | 591.1 | 2385.7 | 2.410 | 2.410 | Identical | 591.1 | 0.66 | 0.66 | Identical | On | On | Same | |12.030V 0.660A | | |12.030V 0.660A
122 | 596.0 | 2405.4 | 2.430 | 2.430 | Identical | 596.0 | 0.66 | 0.66 | Identical | On | On | Same | |12.030V 0.660A | | |12.030V 0.660A
123 | 600.9 | 2425.1 | 2.450 | 2.450 | Identical | 600.9 | 0.67 | 0.67 | Identical | On | On | Same | |12.030V 0.670A | | |12.030V 0.670A
124 | 605.8 | 2444.9 | 2.470 | 2.470 | Identical | 605.8 | 0.67 | 0.67 | Identical | On | On | Same | |12.030V 0.670A | | |12.030V 0.670A
125 | 610.6 | 2464.6 | 2.490 | 2.490 | Identical | 610.6 | 0.68 | 0.68 | Identical | On | On | Same | |12.030V 0.680A | | |12.030V 0.680A
126 | 615.5 | 2484.3 | 2.510 | 2.500 | Within 10 mV (calibration line) | 615.5 | 0.68 | 0.69 | +0.01 A (nearest step) | On | On | Same | |12.030V 0.680A | | |12.030V 0.690A
127 | 620.4 | 2504.0 | 2.530 | 2.520 | Within 10 mV (calibration line) | 620.4 | 0.69 | 0.69 | Identical | On | On | Same | |12.030V 0.690A | | |12.030V 0.690A
128 | 625.3 | 2523.7 | 2.550 | 2.540 | Within 10 mV (calibration line) | 625.3 | 0.70 | 0.70 | Identical | On | On | Same | |12.030V 0.700A | | |12.030V 0.700A
129 | 630.2 | 2543.4 | 2.570 | 2.560 | Within 10 mV (calibration line) | 630.2 | 0.71 | 0.71 | Identical | On | On | Same | |12.030V 0.710A | | |12.030V 0.710A
130 | 635.1 | 2563.2 | 2.590 | 2.580 | Within 10 mV (calibration line) | 635.1 | 0.71 | 0.71 | Identical | On | On | Same | |12.030V 0.710A | | |12.030V 0.710A
131 | 640.0 | 2582.9 | 2.610 | 2.600 | Within 10 mV (calibration line) | 640.0 | 0.72 | 0.72 | Identical | On | On | Same | |12.030V 0.720A | | |12.030V 0.720A
132 | 644.8 | 2602.6 | 2.630 | 2.620 | Within 10 mV (calibration line) | 644.8 | 0.72 | 0.72 | Identical | On | On | Same | |12.030V 0.720A | | |12.030V 0.720A
133 | 649.7 | 2622.3 | 2.650 | 2.640 | Within 10 mV (calibration line) | 649.7 | 0.73 | 0.73 | Identical | On | On | Same | |12.030V 0.730A | | |12.030V 0.730A
134 | 654.6 | 2642.0 | 2.670 | 2.660 | Within 10 mV (calibration line) | 654.6 | 0.73 | 0.73 | Identical | On | On | Same | |12.030V 0.730A | | |12.030V 0.730A
135 | 659.5 | 2661.7 | 2.690 | 2.680 | Within 10 mV (calibration line) | 659.5 | 0.74 | 0.74 | Identical | On | On | Same | |12.030V 0.740A | | |12.030V 0.740A
136 | 664.4 | 2681.5 | 2.710 | 2.700 | Within 10 mV (calibration line) | 664.4 | 0.74 | 0.74 | Identical | On | On | Same | |12.030V 0.740A | | |12.030V 0.740A
137 | 669.3 | 2701.2 | 2.730 | 2.720 | Within 10 mV (calibration line) | 669.3 | 0.75 | 0.75 | Identical | On | On | Same | |12.030V 0.750A | | |12.030V 0.750A
138 | 674.2 | 2720.9 | 2.750 | 2.740 | Within 10 mV (calibration line) | 674.2 | 0.75 | 0.75 | Identical | On | On | Same | |12.030V 0.750A | | |12.030V 0.750A
139 | 679.0 | 2740.6 | 2.770 | 2.760 | Within 10 mV (calibration line) | 679.0 | 0.76 | 0.76 | Identical | On | On | Same | |12.030V 0.760A | | |12.030V 0.760A
140 | 683.9 | 2760.3 | 2.790 | 2.780 | Within 10 mV (calibration line) | 683.9 | 0.76 | 0.77 | +0.01 A (nearest step) | On | On | Same | |12.030V 0.760A | | |12.030V 0.770A
141 | 688.8 | 2780.0 | 2.810 | 2.800 | Within 10 mV (calibration line) | 688.8 | 0.77 | 0.77 | Identical | On | On | Same | |12.030V 0.770A | | |12.030V 0.770A
142 | 693.7 | 2799.8 | 2.820 | 2.820 | Identical | 693.7 | 0.78 | 0.78 | Identical | On | On | Same | |12.030V 0.780A | | |12.030V 0.780A
143 | 698.6 | 2819.5 | 2.840 | 2.840 | Identical | 698.6 | 0.78 | 0.78 | Identical | On | On | Same | |12.030V 0.780A | | |12.030V 0.780A
144 | 703.5 | 2839.2 | 2.860 | 2.860 | Identical | 703.5 | 0.79 | 0.79 | Identical | On | On | Same | |12.030V 0.790A | | |12.030V 0.790A
145 | 708.4 | 2858.9 | 2.880 | 2.880 | Identical | 708.4 | 0.79 | 0.79 | Identical | On | On | Same | |12.030V 0.790A | | |12.030V 0.790A
146 | 713.2 | 2878.6 | 2.900 | 2.900 | Identical | 713.2 | 0.80 | 0.80 | Identical | On | On | Same | |12.030V 0.800A | | |12.030V 0.800A
147 | 718.1 | 2898.3 | 2.920 | 2.920 | Identical | 718.1 | 0.80 | 0.80 | Identical | On | On | Same | |12.030V 0.800A | | |12.030V 0.800A
148 | 723.0 | 2918.1 | 2.940 | 2.940 | Identical | 723.0 | 0.81 | 0.81 | Identical | On | On | Same | |12.030V 0.810A | | |12.030V 0.810A
149 | 727.9 | 2937.8 | 2.960 | 2.960 | Identical | 727.9 | 0.81 | 0.81 | Identical | On | On | Same | |12.030V 0.810A | | |12.030V 0.810A
150 | 732.8 | 2957.5 | 2.980 | 2.980 | Identical | 732.8 | 0.82 | 0.82 | Identical | On | On | Same | |12.030V 0.820A | | |12.030V 0.820A
151 | 737.7 | 2977.2 | 3.000 | 3.000 | Identical | 737.7 | 0.82 | 0.83 | +0.01 A (nearest step) | On | On | Same | |12.030V 0.820A | | |12.030V 0.830A
152 | 742.6 | 2996.9 | 3.020 | 3.020 | Identical | 742.6 | 0.83 | 0.83 | Identical | On | On | Same | |12.030V 0.830A | | |12.030V 0.830A
153 | 747.4 | 3016.6 | 3.040 | 3.030 | Within 10 mV (calibration line) | 747.4 | 0.84 | 0.84 | Identical | On | On | Same | |12.030V 0.840A | | |12.030V 0.840A
154 | 752.3 | 3036.4 | 3.060 | 3.050 | Within 10 mV (calibration line) | 752.3 | 0.84 | 0.84 | Identical | On | On | Same | |12.030V 0.840A | | |12.030V 0.840A
155 | 757.2 | 3056.1 | 3.080 | 3.070 | Within 10 mV (calibration line) | 757.2 | 0.85 | 0.85 | Identical | On | On | Same | |12.030V 0.850A | | |12.030V 0.850A
156 | 762.1 | 3075.8 | 3.100 | 3.090 | Within 10 mV (calibration line) | 762.1 | 0.85 | 0.85 | Identical | On | On | Same | |12.030V 0.850A | | |12.030V 0.850A
157 | 767.0 | 3095.5 | 3.120 | 3.110 | Within 10 mV (calibration line) | 767.0 | 0.86 | 0.86 | Identical | On | On | Same | |12.030V 0.860A | | |12.030V 0.860A
158 | 771.9 | 3115.2 | 3.140 | 3.130 | Within 10 mV (calibration line) | 771.9 | 0.86 | 0.86 | Identical | On | On | Same | |12.030V 0.860A | | |12.030V 0.860A
159 | 776.7 | 3134.9 | 3.160 | 3.150 | Within 10 mV (calibration line) | 776.7 | 0.87 | 0.87 | Identical | On | On | Same | |12.030V 0.870A | | |12.030V 0.870A
160 | 781.6 | 3154.7 | 3.180 | 3.170 | Within 10 mV (calibration line) | 781.6 | 0.87 | 0.88 | +0.01 A (nearest step) | On | On | Same | |12.030V 0.870A | | |12.030V 0.880A
161 | 786.5 | 3174.4 | 3.200 | 3.190 | Within 10 mV (calibration line) | 786.5 | 0.88 | 0.88 | Identical | On | On | Same | |12.030V 0.880A | | |12.030V 0.880A
162 | 791.4 | 3194.1 | 3.220 | 3.210 | Within 10 mV (calibration line) | 791.4 | 0.89 | 0.89 | Identical | On | On | Same | |12.030V 0.890A | | |12.030V 0.890A
163 | 796.3 | 3213.8 | 3.240 | 3.230 | Within 10 mV (calibration line) | 796.3 | 0.89 | 0.89 | Identical | On | On | Same | |12.030V 0.890A | | |12.030V 0.890A
164 | 801.2 | 3233.5 | 3.260 | 3.250 | Within 10 mV (calibration line) | 801.2 | 0.90 | 0.90 | Identical | On | On | Same | |12.030V 0.900A | | |12.030V 0.900A
165 | 806.1 | 3253.2 | 3.280 | 3.270 | Within 10 mV (calibration line) | 806.1 | 0.90 | 0.90 | Identical | On | On | Same | |12.030V 0.900A | | |12.030V 0.900A
166 | 810.9 | 3273.0 | 3.300 | 3.290 | Within 10 mV (calibration line) | 810.9 | 0.91 | 0.91 | Identical | On | On | Same | |12.030V 0.910A | | |12.030V 0.910A
167 | 815.8 | 3292.7 | 3.320 | 3.310 | Within 10 mV (calibration line) | 815.8 | 0.91 | 0.91 | Identical | On | On | Same | |12.030V 0.910A | | |12.030V 0.910A
168 | 820.7 | 3312.4 | 3.340 | 3.330 | Within 10 mV (calibration line) | 820.7 | 0.92 | 0.92 | Identical | On | On | Same | |12.030V 0.920A | | |12.030V 0.920A
169 | 825.6 | 3332.1 | 3.360 | 3.350 | Within 10 mV (calibration line) | 825.6 | 0.92 | 0.93 | +0.01 A (nearest step) | On | On | Same | |12.030V 0.920A | | |12.030V 0.930A
170 | 830.5 | 3351.8 | 3.380 | 3.370 | Within 10 mV (calibration line) | 830.5 | 0.93 | 0.93 | Identical | On | On | Same | |12.030V 0.930A | | |12.030V 0.930A
171 | 835.4 | 3371.5 | 3.400 | 3.390 | Within 10 mV (calibration line) | 835.4 | 0.94 | 0.94 | Identical | On | On | Same | |12.030V 0.940A | | |12.030V 0.940A
172 | 840.3 | 3391.3 | 3.420 | 3.410 | Within 10 mV (calibration line) | 840.3 | 0.94 | 0.94 | Identical | On | On | Same | |12.030V 0.940A | | |12.030V 0.940A
173 | 845.1 | 3411.0 | 3.440 | 3.430 | Within 10 mV (calibration line) | 845.1 | 0.95 | 0.95 | Identical | On | On | Same | |12.030V 0.950A | | |12.030V 0.950A
174 | 850.0 | 3430.7 | 3.460 | 3.450 | Within 10 mV (calibration line) | 850.0 | 0.95 | 0.95 | Identical | On | On | Same | |12.030V 0.950A | | |12.030V 0.950A
175 | 854.9 | 3450.4 | 3.480 | 3.470 | Within 10 mV (calibration line) | 854.9 | 0.96 | 0.96 | Identical | On | On | Same | |12.030V 0.960A | | |12.030V 0.960A
176 | 859.8 | 3470.1 | 3.500 | 3.490 | Within 10 mV (calibration line) | 859.8 | 0.96 | 0.96 | Identical | On | On | Same | |12.030V 0.960A | | |12.030V 0.960A
177 | 864.7 | 3489.8 | 3.510 | 3.510 | Identical | 864.7 | 0.97 | 0.97 | Identical | On | On | Same | |12.030V 0.970A | | |12.030V 0.970A
178 | 869.6 | 3509.6 | 3.530 | 3.530 | Identical | 869.6 | 0.97 | 0.97 | Identical | On | On | Same | |12.030V 0.970A | | |12.030V 0.970A
179 | 874.5 | 3529.3 | 3.550 | 3.550 | Identical | 874.5 | 0.98 | 0.98 | Identical | On | On | Same | |12.030V 0.980A | | |12.030V 0.980A
180 | 879.3 | 3549.0 | 3.570 | 3.570 | Identical | 879.3 | 0.98 | 0.98 | Identical | On | On | Same | |12.030V 0.980A | | |12.030V 0.980A
181 | 884.2 | 3568.7 | 3.590 | 3.580 | Within 10 mV (calibration line) | 884.2 | 0.99 | 0.99 | Identical | On | On | Same | |12.030V 0.990A | | |12.030V 0.990A
182 | 889.1 | 3588.4 | 3.610 | 3.600 | Within 10 mV (calibration line) | 889.1 | 1.00 | 1.00 | Identical | On | On | Same | |12.030V 1.000A | | |12.030V 1.000A
183 | 894.0 | 3608.1 | 3.630 | 3.620 | Within 10 mV (calibration line) | 894.0 | 1.00 | 1.00 | Identical | On | On | Same | |12.030V 1.000A | | |12.030V 1.000A
184 | 898.9 | 3627.9 | 3.650 | 3.640 | Within 10 mV (calibration line) | 898.9 | 1.01 | 1.01 | Identical | On | On | Same | |12.030V 1.010A | | |12.030V 1.010A
185 | 903.8 | 3647.6 | 3.670 | 3.660 | Within 10 mV (calibration line) | 903.8 | 1.01 | 1.01 | Identical | On | On | Same | |12.030V 1.010A | | |12.030V 1.010A
186 | 908.6 | 3667.3 | 3.690 | 3.680 | Within 10 mV (calibration line) | 908.6 | 1.02 | 1.02 | Identical | On | On | Same | |12.030V 1.020A | | |12.030V 1.020A
187 | 913.5 | 3687.0 | 3.710 | 3.700 | Within 10 mV (calibration line) | 913.5 | 1.02 | 1.02 | Identical | On | On | Same | |12.030V 1.020A | | |12.030V 1.020A
188 | 918.4 | 3706.7 | 3.730 | 3.720 | Within 10 mV (calibration line) | 918.4 | 1.03 | 1.03 | Identical | On | On | Same | |12.030V 1.030A | | |12.030V 1.030A
189 | 923.3 | 3726.4 | 3.750 | 3.740 | Within 10 mV (calibration line) | 923.3 | 1.03 | 1.03 | Identical | On | On | Same | |12.030V 1.030A | | |12.030V 1.030A
190 | 928.2 | 3746.2 | 3.770 | 3.760 | Within 10 mV (calibration line) | 928.2 | 1.04 | 1.04 | Identical | On | On | Same | |12.030V 1.040A | | |12.030V 1.040A
191 | 933.1 | 3765.9 | 3.790 | 3.780 | Within 10 mV (calibration line) | 933.1 | 1.04 | 1.04 | Identical | On | On | Same | |12.030V 1.040A | | |12.030V 1.040A
192 | 938.0 | 3785.6 | 3.810 | 3.800 | Within 10 mV (calibration line) | 938.0 | 1.05 | 1.05 | Identical | On | On | Same | |12.030V 1.050A | | |12.030V 1.050A
193 | 942.8 | 3805.3 | 3.830 | 3.820 | Within 10 mV (calibration line) | 942.8 | 1.05 | 1.06 | +0.01 A (nearest step) | On | On | Same | |12.030V 1.050A | | |12.030V 1.060A
194 | 947.7 | 3825.0 | 3.850 | 3.840 | Within 10 mV (calibration line) | 947.7 | 1.06 | 1.06 | Identical | On | On | Same | |12.030V 1.060A | | |12.030V 1.060A
195 | 952.6 | 3844.7 | 3.870 | 3.860 | Within 10 mV (calibration line) | 952.6 | 1.07 | 1.07 | Identical | On | On | Same | |12.030V 1.070A | | |12.030V 1.070A
196 | 957.5 | 3864.5 | 3.890 | 3.880 | Within 10 mV (calibration line) | 957.5 | 1.07 | 1.07 | Identical | On | On | Same | |12.030V 1.070A | | |12.030V 1.070A
197 | 962.4 | 3884.2 | 3.910 | 3.900 | Within 10 mV (calibration line) | 962.4 | 1.08 | 1.08 | Identical | On | On | Same | |12.030V 1.080A | | |12.030V 1.080A
198 | 967.3 | 3903.9 | 3.930 | 3.920 | Within 10 mV (calibration line) | 967.3 | 1.08 | 1.08 | Identical | On | On | Same | |12.030V 1.080A | | |12.030V 1.080A
199 | 972.2 | 3923.6 | 3.950 | 3.940 | Within 10 mV (calibration line) | 972.2 | 1.09 | 1.09 | Identical | On | On | Same | |12.030V 1.090A | | |12.030V 1.090A
200 | 977.0 | 3943.3 | 3.970 | 3.960 | Within 10 mV (calibration line) | 977.0 | 1.09 | 1.09 | Identical | On | On | Same | |12.030V 1.090A | | |12.030V 1.090A
201 | 981.9 | 3963.0 | 3.990 | 3.980 | Within 10 mV (calibration line) | 981.9 | 1.10 | 1.10 | Identical | On | On | Same | |12.030V 1.100A | | |12.030V 1.100A
202 | 986.8 | 3982.8 | 4.010 | 4.000 | Within 10 mV (calibration line) | 986.8 | 1.10 | 1.11 | +0.01 A (nearest step) | On | On | Same | |12.030V 1.100A | | |12.030V 1.110A
203 | 991.7 | 4002.5 | 4.030 | 4.020 | Within 10 mV (calibration line) | 991.7 | 1.11 | 1.11 | Identical | On | On | Same | |12.030V 1.110A | | |12.030V 1.110A
204 | 996.6 | 4022.2 | 4.050 | 4.040 | Within 10 mV (calibration line) | 996.6 | 1.12 | 1.12 | Identical | On | On | Same | |12.030V 1.120A | | |12.030V 1.120A
205 | 1001.5 | 4041.9 | 4.070 | 4.060 | Within 10 mV (calibration line) | 1001.5 | 1.12 | 1.12 | Identical | On | On | Same | |12.030V 1.120A | | |12.030V 1.120A
206 | 1006.4 | 4061.6 | 4.090 | 4.080 | Within 10 mV (calibration line) | 1006.4 | 1.13 | 1.13 | Identical | On | On | Same | |12.030V 1.130A | | |12.030V 1.130A
207 | 1011.2 | 4081.3 | 4.110 | 4.100 | Within 10 mV (calibration line) | 1011.2 | 1.13 | 1.13 | Identical | On | On | Same | |12.030V 1.130A | | |12.030V 1.130A
208 | 1016.1 | 4101.1 | 4.130 | 4.110 | -20 mV (end of old +30 mV band) | 1016.1 | 1.14 | 1.14 | Identical | On | On | Same | |12.030V 1.140A | | |12.030V 1.140A
209 | 1021.0 | 4120.8 | 4.150 | 4.130 | -20 mV (end of old +30 mV band) | 1021.0 | 1.14 | 1.14 | Identical | On | On | Same | |12.030V 1.140A | | |12.030V 1.140A
210 | 1025.9 | 4140.5 | 4.170 | 4.150 | -20 mV (end of old +30 mV band) | 1025.9 | 1.15 | 1.15 | Identical | On | On | Same | |12.030V 1.150A | | |12.030V 1.150A
211 | 1030.8 | 4160.2 | 4.170 | 4.170 | Identical | 1030.8 | 1.15 | 1.15 | Identical | On | On | Same | |12.030V 1.150A | | |12.030V 1.150A
212 | 1035.7 | 4179.9 | 4.180 | 4.190 | Within 10 mV (calibration line) | 1035.7 | 1.16 | 1.16 | Identical | On | On | Same | |12.030V 1.160A | | |12.030V 1.160A
213 | 1040.5 | 4199.6 | 4.200 | 4.210 | Within 10 mV (calibration line) | 1040.5 | 1.16 | 1.17 | +0.01 A (nearest step) | On | On | Same | |12.030V 1.160A | | |12.030V 1.170A
214 | 1045.4 | 4219.4 | 4.220 | 4.230 | Within 10 mV (calibration line) | 1045.4 | 1.17 | 1.17 | Identical | On | On | Same | |12.030V 1.170A | | |12.030V 1.170A
215 | 1050.3 | 4239.1 | 4.240 | 4.250 | Within 10 mV (calibration line) | 1050.3 | 1.18 | 1.18 | Identical | On | On | Same | |12.030V 1.180A | | |12.030V 1.180A
216 | 1055.2 | 4258.8 | 4.260 | 4.270 | Within 10 mV (calibration line) | 1055.2 | 1.18 | 1.18 | Identical | On | On | Same | |12.030V 1.180A | | |12.030V 1.180A
217 | 1060.1 | 4278.5 | 4.280 | 4.290 | Within 10 mV (calibration line) | 1060.1 | 1.19 | 1.19 | Identical | On | On | Same | |12.030V 1.190A | | |12.030V 1.190A
218 | 1065.0 | 4298.2 | 4.300 | 4.310 | Within 10 mV (calibration line) | 1065.0 | 1.19 | 1.19 | Identical | On | On | Same | |12.030V 1.190A | | |12.030V 1.190A
219 | 1069.9 | 4317.9 | 4.320 | 4.330 | Within 10 mV (calibration line) | 1069.9 | 1.20 | 1.20 | Identical | On | On | Same | |12.030V 1.200A | | |12.030V 1.200A
220 | 1074.7 | 4337.7 | 4.340 | 4.350 | Within 10 mV (calibration line) | 1074.7 | 1.20 | 1.20 | Identical | On | On | Same | |12.030V 1.200A | | |12.030V 1.200A
221 | 1079.6 | 4357.4 | 4.360 | 4.370 | Within 10 mV (calibration line) | 1079.6 | 1.21 | 1.21 | Identical | On | On | Same | |12.030V 1.210A | | |12.030V 1.210A
222 | 1084.5 | 4377.1 | 4.380 | 4.390 | Within 10 mV (calibration line) | 1084.5 | 1.21 | 1.22 | +0.01 A (nearest step) | On | On | Same | |12.030V 1.210A | | |12.030V 1.220A
223 | 1089.4 | 4396.8 | 4.400 | 4.410 | Within 10 mV (calibration line) | 1089.4 | 1.22 | 1.22 | Identical | On | On | Same | |12.030V 1.220A | | |12.030V 1.220A
224 | 1094.3 | 4416.5 | 4.420 | 4.430 | Within 10 mV (calibration line) | 1094.3 | 1.23 | 1.23 | Identical | On | On | Same | |12.030V 1.230A | | |12.030V 1.230A
225 | 1099.2 | 4436.2 | 4.440 | 4.450 | Within 10 mV (calibration line) | 1099.2 | 1.23 | 1.23 | Identical | On | On | Same | |12.030V 1.230A | | |12.030V 1.230A
226 | 1104.1 | 4456.0 | 4.460 | 4.470 | Within 10 mV (calibration line) | 1104.1 | 1.24 | 1.24 | Identical | On | On | Same | |12.030V 1.240A | | |12.030V 1.240A
227 | 1108.9 | 4475.7 | 4.480 | 4.490 | Within 10 mV (calibration line) | 1108.9 | 1.24 | 1.24 | Identical | On | On | Same | |12.030V 1.240A | | |12.030V 1.240A
228 | 1113.8 | 4495.4 | 4.500 | 4.510 | Within 10 mV (calibration line) | 1113.8 | 1.25 | 1.25 | Identical | On | On | Same | |12.030V 1.250A | | |12.030V 1.250A
229 | 1118.7 | 4515.1 | 4.520 | 4.530 | Within 10 mV (calibration line) | 1118.7 | 1.25 | 1.25 | Identical | On | On | Same | |12.030V 1.250A | | |12.030V 1.250A
230 | 1123.6 | 4534.8 | 4.540 | 4.550 | Within 10 mV (calibration line) | 1123.6 | 1.26 | 1.26 | Identical | On | On | Same | |12.030V 1.260A | | |12.030V 1.260A
231 | 1128.5 | 4554.5 | 4.560 | 4.570 | Within 10 mV (calibration line) | 1128.5 | 1.26 | 1.26 | Identical | On | On | Same | |12.030V 1.260A | | |12.030V 1.260A
232 | 1133.4 | 4574.3 | 4.580 | 4.590 | Within 10 mV (calibration line) | 1133.4 | 1.27 | 1.27 | Identical | On | On | Same | |12.030V 1.270A | | |12.030V 1.270A
233 | 1138.3 | 4594.0 | 4.600 | 4.610 | Within 10 mV (calibration line) | 1138.3 | 1.28 | 1.28 | Identical | On | On | Same | |12.030V 1.280A | | |12.030V 1.280A
234 | 1143.1 | 4613.7 | 4.620 | 4.630 | Within 10 mV (calibration line) | 1143.1 | 1.28 | 1.28 | Identical | On | On | Same | |12.030V 1.280A | | |12.030V 1.280A
235 | 1148.0 | 4633.4 | 4.640 | 4.640 | Identical | 1148.0 | 1.29 | 1.29 | Identical | On | On | Same | |12.030V 1.290A | | |12.030V 1.290A
236 | 1152.9 | 4653.1 | 4.660 | 4.660 | Identical | 1152.9 | 1.29 | 1.29 | Identical | On | On | Same | |12.030V 1.290A | | |12.030V 1.290A
237 | 1157.8 | 4672.8 | 4.680 | 4.680 | Identical | 1157.8 | 1.30 | 1.30 | Identical | On | On | Same | |12.030V 1.300A | | |12.030V 1.300A
238 | 1162.7 | 4692.6 | 4.700 | 4.700 | Identical | 1162.7 | 1.30 | 1.30 | Identical | On | On | Same | |12.030V 1.300A | | |12.030V 1.300A
239 | 1167.6 | 4712.3 | 4.720 | 4.720 | Identical | 1167.6 | 1.31 | 1.31 | Identical | On | On | Same | |12.030V 1.310A | | |12.030V 1.310A
240 | 1172.4 | 4732.0 | 4.740 | 4.740 | Identical | 1172.4 | 1.31 | 1.31 | Identical | On | On | Same | |12.030V 1.310A | | |12.030V 1.310A
241 | 1177.3 | 4751.7 | 4.760 | 4.760 | Identical | 1177.3 | 1.32 | 1.32 | Identical | On | On | Same | |12.030V 1.320A | | |12.030V 1.320A
242 | 1182.2 | 4771.4 | 4.780 | 4.780 | Identical | 1182.2 | 1.32 | 1.32 | Identical | On | On | Same | |12.030V 1.320A | | |12.030V 1.320A
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
311 | 1519.3 | 6131.9 | 6.130 | 6.140 | Within 10 mV (calibration line) | 1519.3 | 1.70 | 1.70 | Identical | On | On | Same | |12.030V 1.700A | | |12.030V 1.700A
312 | 1524.2 | 6151.6 | 6.150 | 6.160 | Within 10 mV (calibration line) | 1524.2 | 1.71 | 1.71 | Identical | On | On | Same | |12.030V 1.710A | | |12.030V 1.710A
313 | 1529.1 | 6171.3 | 6.170 | 6.180 | Within 10 mV (calibration line) | 1529.1 | 1.71 | 1.71 | Identical | On | On | Same | |12.030V 1.710A | | |12.030V 1.710A
314 | 1534.0 | 6191.0 | 6.190 | 6.200 | Within 10 mV (calibration line) | 1534.0 | 1.72 | 1.72 | Identical | On | On | Same | |12.030V 1.720A | | |12.030V 1.720A
315 | 1538.8 | 6210.7 | 6.210 | 6.220 | Within 10 mV (calibration line) | 1538.8 | 1.72 | 1.73 | +0.01 A (nearest step) | On | On | Same | |12.030V 1.720A | | |12.030V 1.730A
316 | 1543.7 | 6230.5 | 6.230 | 6.240 | Within 10 mV (calibration line) | 1543.7 | 1.73 | 1.73 | Identical | On | On | Same | |12.030V 1.730A | | |12.030V 1.730A
317 | 1548.6 | 6250.2 | 6.250 | 6.250 | Identical | 1548.6 | 1.74 | 1.74 | Identical | On | On | Same | |12.030V 1.740A | | |12.030V 1.740A
318 | 1553.5 | 6269.9 | 6.260 | 6.270 | Within 10 mV (calibration line) | 1553.5 | 1.74 | 1.74 | Identical | On | On | Same | |12.030V 1.740A | | |12.030V 1.740A
319 | 1558.4 | 6289.6 | 6.280 | 6.290 | Within 10 mV (calibration line) | 1558.4 | 1.75 | 1.75 | Identical | On | On | Same | |12.030V 1.750A | | |12.030V 1.750A
320 | 1563.3 | 6309.3 | 6.300 | 6.310 | Within 10 mV (calibration line) | 1563.3 | 1.75 | 1.75 | Identical | On | On | Same | |12.030V 1.750A | | |12.030V 1.750A
321 | 1568.1 | 6329.0 | 6.320 | 6.330 | Within 10 mV (calibration line) | 1568.1 | 1.76 | 1.76 | Identical | On | On | Same | |12.030V 1.760A | | |12.030V 1.760A
322 | 1573.0 | 6348.8 | 6.340 | 6.350 | Within 10 mV (calibration line) | 1573.0 | 1.76 | 1.76 | Identical | On | On | Same | |12.030V 1.760A | | |12.030V 1.760A
323 | 1577.9 | 6368.5 | 6.360 | 6.370 | Within 10 mV (calibration line) | 1577.9 | 1.77 | 1.77 | Identical | On | On | Same | |12.030V 1.770A | | |12.030V 1.770A
324 | 1582.8 | 6388.2 | 6.380 | 6.390 | Within 10 mV (calibration line) | 1582.8 | 1.77 | 1.77 | Identical | On | On | Same | |12.030V 1.770A | | |12.030V 1.770A
325 | 1587.7 | 6407.9 | 6.400 | 6.410 | Within 10 mV (calibration line) | 1587.7 | 1.78 | 1.78 | Identical | On | On | Same | |12.030V 1.780A | | |12.030V 1.780A
326 | 1592.6 | 6427.6 | 6.420 | 6.430 | Within 10 mV (calibration line) | 1592.6 | 1.78 | 1.79 | +0.01 A (nearest step) | On | On | Same | |12.030V 1.780A | | |12.030V 1.790A
327 | 1597.5 | 6447.3 | 6.440 | 6.450 | Within 10 mV (calibration line) | 1597.5 | 1.79 | 1.79 | Identical | On | On | Same | |12.030V 1.790A | | |12.030V 1.790A
328 | 1602.3 | 6467.1 | 6.460 | 6.470 | Within 10 mV (calibration line) | 1602.3 | 1.80 | 1.80 | Identical | On | On | Same | |12.030V 1.800A | | |12.030V 1.800A
329 | 1607.2 | 6486.8 | 6.480 | 6.490 | Within 10 mV (calibration line) | 1607.2 | 1.80 | 1.80 | Identical | On | On | Same | |12.030V 1.800A | | |12.030V 1.800A
330 | 1612.1 | 6506.5 | 6.500 | 6.510 | Within 10 mV (calibration line) | 1612.1 | 1.81 | 1.81 | Identical | On | On | Same | |12.030V 1.810A | | |12.030V 1.810A
331 | 1617.0 | 6526.2 | 6.520 | 6.530 | Within 10 mV (calibration line) | 1617.0 | 1.81 | 1.81 | Identical | On | On | Same | |12.030V 1.810A | | |12.030V 1.810A
332 | 1621.9 | 6545.9 | 6.540 | 6.550 | Within 10 mV (calibration line) | 1621.9 | 1.82 | 1.82 | Identical | On | On | Same | |12.030V 1.820A | | |12.030V 1.820A
333 | 1626.8 | 6565.6 | 6.560 | 6.570 | Within 10 mV (calibration line) | 1626.8 | 1.82 | 1.82 | Identical | On | On | Same | |12.030V 1.820A | | |12.030V 1.820A
334 | 1631.7 | 6585.4 | 6.580 | 6.590 | Within 10 mV (calibration line) | 1631.7 | 1.83 | 1.83 | Identical | On | On | Same | |12.030V 1.830A | | |12.030V 1.830A
335 | 1636.5 | 6605.1 | 6.600 | 6.610 | Within 10 mV (calibration line) | 1636.5 | 1.83 | 1.84 | +0.01 A (nearest step) | On | On | Same | |12.030V 1.830A | | |12.030V 1.840A
336 | 1641.4 | 6624.8 | 6.620 | 6.630 | Within 10 mV (calibration line) | 1641.4 | 1.84 | 1.84 | Identical | On | On | Same | |12.030V 1.840A | | |12.030V 1.840A
337 | 1646.3 | 6644.5 | 6.640 | 6.650 | Within 10 mV (calibration line) | 1646.3 | 1.85 | 1.85 | Identical | On | On | Same | |12.030V 1.850A | | |12.030V 1.850A
338 | 1651.2 | 6664.2 | 6.660 | 6.670 | Within 10 mV (calibration line) | 1651.2 | 1.85 | 1.85 | Identical | On | On | Same | |12.030V 1.850A | | |12.030V 1.850A
339 | 1656.1 | 6683.9 | 6.680 | 6.690 | Within 10 mV (calibration line) | 1656.1 | 1.86 | 1.86 | Identical | On | On | Same | |12.030V 1.860A | | |12.030V 1.860A
340 | 1661.0 | 6703.7 | 6.700 | 6.710 | Within 10 mV (calibration line) | 1661.0 | 1.86 | 1.86 | Identical | On | On | Same | |12.030V 1.860A | | |12.030V 1.860A
341 | 1665.9 | 6723.4 | 6.720 | 6.730 | Within 10 mV (calibration line) | 1665.9 | 1.87 | 1.87 | Identical | On | On | Same | |12.030V 1.870A | | |12.030V 1.870A
342 | 1670.7 | 6743.1 | 6.740 | 6.750 | Within 10 mV (calibration line) | 1670.7 | 1.87 | 1.87 | Identical | On | On | Same | |12.030V 1.870A | | |12.030V 1.870A
343 | 1675.6 | 6762.8 | 6.760 | 6.770 | Within 10 mV (calibration line) | 1675.6 | 1.88 | 1.88 | Identical | On | On | Same | |12.030V 1.880A | | |12.030V 1.880A
344 | 1680.5 | 6782.5 | 6.780 | 6.780 | Identical | 1680.5 | 1.88 | 1.88 | Identical | On | On | Same | |12.030V 1.880A | | |12.030V 1.880A
345 | 1685.4 | 6802.2 | 6.800 | 6.800 | Identical | 1685.4 | 1.89 | 1.89 | Identical | On | On | Same | |12.030V 1.890A | | |12.030V 1.890A
346 | 1690.3 | 6822.0 | 6.820 | 6.820 | Identical | 1690.3 | 1.89 | 1.89 | Identical | On | On | Same | |12.030V 1.890A | | |12.030V 1.890A
347 | 1695.2 | 6841.7 | 6.840 | 6.840 | Identical | 1695.2 | 1.90 | 1.90 | Identical | On | On | Same | |12.030V 1.900A | | |12.030V 1.900A
348 | 1700.0 | 6861.4 | 6.860 | 6.860 | Identical | 1700.0 | 1.91 | 1.91 | Identical | On | On | Same | |12.030V 1.910A | | |12.030V 1.910A
349 | 1704.9 | 6881.1 | 6.880 | 6.880 | Identical | 1704.9 | 1.91 | 1.91 | Identical | On | On | Same | |12.030V 1.910A | | |12.030V 1.910A
350 | 1709.8 | 6900.8 | 6.900 | 6.900 | Identical | 1709.8 | 1.92 | 1.92 | Identical | On | On | Same | |12.030V 1.920A | | |12.030V 1.920A
351 | 1714.7 | 6920.5 | 6.920 | 6.920 | Identical | 1714.7 | 1.92 | 1.92 | Identical | On | On | Same | |12.030V 1.920A | | |12.030V 1.920A
352 | 1719.6 | 6940.3 | 6.940 | 6.940 | Identical | 1719.6 | 1.93 | 1.93 | Identical | On | On | Same | |12.030V 1.930A | | |12.030V 1.930A
353 | 1724.5 | 6960.0 | 6.950 | 6.960 | Within 10 mV (calibration line) | 1724.5 | 1.93 | 1.93 | Identical | On | On | Same | |12.030V 1.930A | | |12.030V 1.930A
354 | 1729.4 | 6979.7 | 6.970 | 6.980 | Within 10 mV (calibration line) | 1729.4 | 1.94 | 1.94 | Identical | On | On | Same | |12.030V 1.940A | | |12.030V 1.940A
355 | 1734.2 | 6999.4 | 6.990 | 7.000 | Within 10 mV (calibration line) | 1734.2 | 1.94 | 1.94 | Identical | On | On | Same | |12.030V 1.940A | | |12.030V 1.940A
356 | 1739.1 | 7019.1 | 7.010 | 7.020 | Within 10 mV (calibration line) | 1739.1 | 1.95 | 1.95 | Identical | On | On | Same | |12.030V 1.950A | | |12.030V 1.950A
357 | 1744.0 | 7038.8 | 7.030 | 7.040 | Within 10 mV (calibration line) | 1744.0 | 1.96 | 1.96 | Identical | On | On | Same | |12.030V 1.960A | | |12.030V 1.960A
358 | 1748.9 | 7058.6 | 7.050 | 7.060 | Within 10 mV (calibration line) | 1748.9 | 1.96 | 1.96 | Identical | On | On | Same | |12.030V 1.960A | | |12.030V 1.960A
359 | 1753.8 | 7078.3 | 7.070 | 7.080 | Within 10 mV (calibration line) | 1753.8 | 1.97 | 1.97 | Identical | On | On | Same | |12.030V 1.970A | | |12.030V 1.970A
360 | 1758.7 | 7098.0 | 7.090 | 7.100 | Within 10 mV (calibration line) | 1758.7 | 1.97 | 1.97 | Identical | On | On | Same | |12.030V 1.970A | | |12.030V 1.970A
361 | 1763.6 | 7117.7 | 7.110 | 7.120 | Within 10 mV (calibration line) | 1763.6 | 1.98 | 1.98 | Identical | On | On | Same | |12.030V 1.980A | | |12.030V 1.980A
362 | 1768.4 | 7137.4 | 7.130 | 7.140 | Within 10 mV (calibration line) | 1768.4 | 1.98 | 1.98 | Identical | On | On | Same | |12.030V 1.980A | | |12.030V 1.980A
363 | 1773.3 | 7157.1 | 7.150 | 7.160 | Within 10 mV (calibration line) | 1773.3 | 1.99 | 1.99 | Identical | On | On | Same | |12.030V 1.990A | | |12.030V 1.990A
364 | 1778.2 | 7176.9 | 7.170 | 7.180 | Within 10 mV (calibration line) | 1778.2 | 1.99 | 1.99 | Identical | On | On | Same | |12.030V 1.990A | | |12.030V 1.990A
365 | 1783.1 | 7196.6 | 7.190 | 7.200 | Within 10 mV (calibration line) | 1783.1 | 2.00 | 2.00 | Identical | On | On | Same | |12.030V 2.000A | | |12.030V 2.000A
366 | 1788.0 | 7216.3 | 7.210 | 7.220 | Within 10 mV (calibration line) | 1788.0 | 2.00 | 2.01 | +0.01 A (nearest step) | On | On | Same | |12.030V 2.000A | | |12.030V 2.010A
367 | 1792.9 | 7236.0 | 7.230 | 7.240 | Within 10 mV (calibration line) | 1792.9 | 2.01 | 2.01 | Identical | On | On | Same | |12.030V 2.010A | | |12.030V 2.010A
368 | 1797.8 | 7255.7 | 7.250 | 7.260 | Within 10 mV (calibration line) | 1797.8 | 2.02 | 2.02 | Identical | On | On | Same | |12.030V 2.020A | | |12.030V 2.020A
369 | 1802.6 | 7275.4 | 7.270 | 7.280 | Within 10 mV (calibration line) | 1802.6 | 2.02 | 2.02 | Identical | On | On | Same | |12.030V 2.020A | | |12.030V 2.020A
370 | 1807.5 | 7295.2 | 7.290 | 7.300 | Within 10 mV (calibration line) | 1807.5 | 2.03 | 2.03 | Identical | On | On | Same | |12.030V 2.030A | | |12.030V 2.030A
371 | 1812.4 | 7314.9 | 7.310 | 7.320 | Within 10 mV (calibration line) | 1812.4 | 2.03 | 2.03 | Identical | On | On | Same | |12.030V 2.030A | | |12.030V 2.030A
372 | 1817.3 | 7334.6 | 7.330 | 7.330 | Identical | 1817.3 | 2.04 | 2.04 | Identical | On | On | Same | |12.030V 2.040A | | |12.030V 2.040A
373 | 1822.2 | 7354.3 | 7.350 | 7.350 | Identical | 1822.2 | 2.04 | 2.04 | Identical | On | On | Same | |12.030V 2.040A | | |12.030V 2.040A
374 | 1827.1 | 7374.0 | 7.370 | 7.370 | Identical | 1827.1 | 2.05 | 2.05 | Identical | On | On | Same | |12.030V 2.050A | | |12.030V 2.050A
375 | 1831.9 | 7393.7 | 7.390 | 7.390 | Identical | 1831.9 | 2.05 | 2.05 | Identical | On | On | Same | |12.030V 2.050A | | |12.030V 2.050A
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
446 | 2178.8 | 8793.6 | 8.780 | 8.790 | Within 10 mV (calibration line) | 2178.8 | 2.44 | 2.45 | +0.01 A (nearest step) | On | On | Same | |12.030V 2.440A | | |12.030V 2.450A
447 | 2183.7 | 8813.3 | 8.800 | 8.810 | Within 10 mV (calibration line) | 2183.7 | 2.45 | 2.45 | Identical | On | On | Same | |12.030V 2.450A | | |12.030V 2.450A
448 | 2188.6 | 8833.1 | 8.820 | 8.830 | Within 10 mV (calibration line) | 2188.6 | 2.46 | 2.46 | Identical | On | On | Same | |12.030V 2.460A | | |12.030V 2.460A
449 | 2193.5 | 8852.8 | 8.840 | 8.850 | Within 10 mV (calibration line) | 2193.5 | 2.46 | 2.46 | Identical | On | On | Same | |12.030V 2.460A | | |12.030V 2.460A
450 | 2198.3 | 8872.5 | 8.860 | 8.870 | Within 10 mV (calibration line) | 2198.3 | 2.47 | 2.47 | Identical | On | On | Same | |12.030V 2.470A | | |12.030V 2.470A
451 | 2203.2 | 8892.2 | 8.880 | 8.890 | Within 10 mV (calibration line) | 2203.2 | 2.47 | 2.47 | Identical | On | On | Same | |12.030V 2.470A | | |12.030V 2.470A
452 | 2208.1 | 8911.9 | 8.900 | 8.910 | Within 10 mV (calibration line) | 2208.1 | 2.48 | 2.48 | Identical | On | On | Same | |12.030V 2.480A | | |12.030V 2.480A
453 | 2213.0 | 8931.6 | 8.920 | 8.920 | Identical | 2213.0 | 2.48 | 2.48 | Identical | On | On | Same | |12.030V 2.480A | | |12.030V 2.480A
454 | 2217.9 | 8951.4 | 8.940 | 8.940 | Identical | 2217.9 | 2.49 | 2.49 | Identical | On | On | Same | |12.030V 2.490A | | |12.030V 2.490A
455 | 2222.8 | 8971.1 | 8.960 | 8.960 | Identical | 2222.8 | ERR (999.23) | 2.49 | Gap bug fixed | Off | On | Different | |12.030V 999.2A0| | |12.030V 2.490A
456 | 2227.7 | 8990.8 | 8.980 | 8.980 | Identical | 2227.7 | ERR (999.23) | 2.50 | Gap bug fixed | Off | On | Different | |12.030V 999.2A0| | |12.030V 2.500A
457 | 2232.5 | 9010.5 | 9.000 | 9.000 | Identical | 2232.5 | 2.50 | 2.51 | +0.01 A (nearest step) | On | On | Same | |12.030V 2.500A0| | |12.030V 2.510A
458 | 2237.4 | 9030.2 | 9.020 | 9.020 | Identical | 2237.4 | 2.51 | 2.51 | Identical | On | On | Same | |12.030V 2.510A0| | |12.030V 2.510A
459 | 2242.3 | 9049.9 | 9.030 | 9.040 | Within 10 mV (calibration line) | 2242.3 | 2.52 | 2.52 | Identical | On | On | Same | |12.030V 2.520A0| | |12.030V 2.520A
460 | 2247.2 | 9069.7 | 9.050 | 9.060 | Within 10 mV (calibration line) | 2247.2 | 2.52 | 2.52 | Identical | On | On | Same | |12.030V 2.520A0| | |12.030V 2.520A
461 | 2252.1 | 9089.4 | 9.070 | 9.080 | Within 10 mV (calibration line) | 2252.1 | 2.53 | 2.53 | Identical | On | On | Same | |12.030V 2.530A0| | |12.030V 2.530A
462 | 2257.0 | 9109.1 | 9.090 | 9.100 | Within 10 mV (calibration line) | 2257.0 | 2.53 | 2.53 | Identical | On | On | Same | |12.030V 2.530A0| | |12.030V 2.530A
463 | 2261.8 | 9128.8 | 9.110 | 9.120 | Within 10 mV (calibration line) | 2261.8 | 2.54 | 2.54 | Identical | On | On | Same | |12.030V 2.540A0| | |12.030V 2.540A
464 | 2266.7 | 9148.5 | 9.130 | 9.140 | Within 10 mV (calibration line) | 2266.7 | 2.54 | 2.54 | Identical | On | On | Same | |12.030V 2.540A0| | |12.030V 2.540A
465 | 2271.6 | 9168.2 | 9.150 | 9.160 | Within 10 mV (calibration line) | 2271.6 | 2.55 | 2.55 | Identical | On | On | Same | |12.030V 2.550A0| | |12.030V 2.550A
466 | 2276.5 | 9188.0 | 9.170 | 9.180 | Within 10 mV (calibration line) | 2276.5 | 2.55 | 2.56 | +0.01 A (nearest step) | On | On | Same | |12.030V 2.550A0| | |12.030V 2.560A
467 | 2281.4 | 9207.7 | 9.190 | 9.200 | Within 10 mV (calibration line) | 2281.4 | 2.56 | 2.56 | Identical | On | On | Same | |12.030V 2.560A0| | |12.030V 2.560A
468 | 2286.3 | 9227.4 | 9.210 | 9.220 | Within 10 mV (calibration line) | 2286.3 | 2.57 | 2.57 | Identical | On | On | Same | |12.030V 2.570A0| | |12.030V 2.570A
469 | 2291.2 | 9247.1 | 9.230 | 9.240 | Within 10 mV (calibration line) | 2291.2 | 2.57 | 2.57 | Identical | On | On | Same | |12.030V 2.570A0| | |12.030V 2.570A
470 | 2296.0 | 9266.8 | 9.250 | 9.260 | Within 10 mV (calibration line) | 2296.0 | 2.58 | 2.58 | Identical | On | On | Same | |12.030V 2.580A0| | |12.030V 2.580A
471 | 2300.9 | 9286.5 | 9.270 | 9.280 | Within 10 mV (calibration line) | 2300.9 | 2.58 | 2.58 | Identical | On | On | Same | |12.030V 2.580A0| | |12.030V 2.580A
472 | 2305.8 | 9306.3 | 9.290 | 9.300 | Within 10 mV (calibration line) | 2305.8 | 2.59 | 2.59 | Identical | On | On | Same | |12.030V 2.590A0| | |12.030V 2.590A
473 | 2310.7 | 9326.0 | 9.310 | 9.320 | Within 10 mV (calibration line) | 2310.7 | 2.59 | 2.59 | Identical | On | On | Same | |12.030V 2.590A0| | |12.030V 2.590A
474 | 2315.6 | 9345.7 | 9.330 | 9.340 | Within 10 mV (calibration line) | 2315.6 | 2.60 | 2.60 | Identical | On | On | Same | |12.030V 2.600A0| | |12.030V 2.600A
475 | 2320.5 | 9365.4 | 9.350 | 9.360 | Within 10 mV (calibration line) | 2320.5 | 2.60 | 2.60 | Identical | On | On | Same | |12.030V 2.600A0| | |12.030V 2.600A
476 | 2325.4 | 9385.1 | 9.370 | 9.380 | Within 10 mV (calibration line) | 2325.4 | 2.61 | 2.61 | Identical | On | On | Same | |12.030V 2.610A0| | |12.030V 2.610A
477 | 2330.2 | 9404.8 | 9.390 | 9.400 | Within 10 mV (calibration line) | 2330.2 | 2.61 | 2.61 | Identical | On | On | Same | |12.030V 2.610A0| | |12.030V 2.610A
478 | 2335.1 | 9424.6 | 9.410 | 9.420 | Within 10 mV (calibration line) | 2335.1 | 2.62 | 2.62 | Identical | On | On | Same | |12.030V 2.620A0| | |12.030V 2.620A
479 | 2340.0 | 9444.3 | 9.430 | 9.440 | Within 10 mV (calibration line) | 2340.0 | 2.63 | 2.63 | Identical | On | On | Same | |12.030V 2.630A0| | |12.030V 2.630A
480 | 2344.9 | 9464.0 | 9.450 | 9.460 | Within 10 mV (calibration line) | 2344.9 | 2.63 | 2.63 | Identical | On | On | Same | |12.030V 2.630A0| | |12.030V 2.630A
481 | 2349.8 | 9483.7 | 9.470 | 9.470 | Identical | 2349.8 | 2.64 | 2.64 | Identical | On | On | Same | |12.030V 2.640A0| | |12.030V 2.640A
482 | 2354.7 | 9503.4 | 9.490 | 9.490 | Identical | 2354.7 | 2.64 | 2.64 | Identical | On | On | Same | |12.030V 2.640A0| | |12.030V 2.640A
483 | 2359.6 | 9523.1 | 9.510 | 9.510 | Identical | 2359.6 | 2.65 | 2.65 | Identical | On | On | Same | |12.030V 2.650A0| | |12.030V 2.650A
484 | 2364.4 | 9542.9 | 9.530 | 9.530 | Identical | 2364.4 | 2.65 | 2.65 | Identical | On | On | Same | |12.030V 2.650A0| | |12.030V 2.650A
485 | 2369.3 | 9562.6 | 9.550 | 9.550 | Identical | 2369.3 | 2.66 | 2.66 | Identical | On | On | Same | |12.030V 2.660A0| | |12.030V 2.660A
486 | 2374.2 | 9582.3 | 9.570 | 9.570 | Identical | 2374.2 | 2.66 | 2.66 | Identical | On | On | Same | |12.030V 2.660A0| | |12.030V 2.660A
487 | 2379.1 | 9602.0 | 9.590 | 9.590 | Identical | 2379.1 | 2.67 | 2.67 | Identical | On | On | Same | |12.030V 2.670A0| | |12.030V 2.670A
488 | 2384.0 | 9621.7 | 9.610 | 9.610 | Identical | 2384.0 | 2.67 | 2.67 | Identical | On | On | Same | |12.030V 2.670A0| | |12.030V 2.670A
489 | 2388.9 | 9641.4 | 9.630 | 9.630 | Identical | 2388.9 | 2.68 | 2.68 | Identical | On | On | Same | |12.030V 2.680A0| | |12.030V 2.680A
490 | 2393.7 | 9661.2 | 9.650 | 9.650 | Identical | 2393.7 | 2.68 | 2.69 | +0.01 A (nearest step) | On | On | Same | |12.030V 2.680A0| | |12.030V 2.690A
491 | 2398.6 | 9680.9 | 9.670 | 9.670 | Identical | 2398.6 | 2.69 | 2.69 | Identical | On | On | Same | |12.030V 2.690A0| | |12.030V 2.690A
492 | 2403.5 | 9700.6 | 9.690 | 9.690 | Identical | 2403.5 | 2.70 | 2.70 | Identical | On | On | Same | |12.030V 2.700A0| | |12.030V 2.700A
493 | 2408.4 | 9720.3 | 9.710 | 9.710 | Identical | 2408.4 | 2.70 | 2.70 | Identical | On | On | Same | |12.030V 2.700A0| | |12.030V 2.700A
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
521 | 2545.2 | 10272.4 | 10.260 | 10.260 | Identical | 2545.2 | 2.86 | 2.86 | Identical | On | On | Same | |12.030V 2.860A0| | |12.030V 2.860A
522 | 2550.1 | 10292.1 | 10.280 | 10.280 | Identical | 2550.1 | 2.86 | 2.86 | Identical | On | On | Same | |12.030V 2.860A0| | |12.030V 2.860A
523 | 2555.0 | 10311.8 | 10.300 | 10.300 | Identical | 2555.0 | 2.87 | 2.87 | Identical | On | On | Same | |12.030V 2.870A0| | |12.030V 2.870A
524 | 2559.8 | 10331.5 | 10.320 | 10.320 | Identical | 2559.8 | 2.87 | 2.87 | Identical | On | On | Same | |12.030V 2.870A0| | |12.030V 2.870A
525 | 2564.7 | 10351.2 | 10.340 | 10.340 | Identical | 2564.7 | 2.88 | 2.88 | Identical | On | On | Same | |12.030V 2.880A0| | |12.030V 2.880A

Sheet: LCD Scenarios
LCD, LED and screen-clear behavior in event scenarios
Rows are exactly what the 16x2 LCD shows (top row = CH2, bottom row = CH1). LEDs = D3 (CH1) then D5 (CH2), 1 = on. Clears = lcd.clear() calls in the cycle.
Scenario | Step | Stimulus | v0.3.0 top row | v0.3.0 bottom row | v0.3.0 LEDs | v0.3.0 clears | v1.0.0 top row | v1.0.0 bottom row | v1.0.0 LEDs | v1.0.0 clears | Comment
Over range | 0 | CH1 12.03 V / 0.72 A, CH2 12.03 V / 0.72 A | |12.030V 0.720A0| | |12.030V 0.720A0| | 11 | 0 | |12.030V 0.720A | | |12.030V 0.720A | | 11 | 0
Over range | 1 | CH1 current ADC 1000 (above 5.00 A) | |12.030V 0.720A0| | |12.030V 999.2A0| | 01 | 0 | |12.030V 0.720A | | |12.030V OL | | 11 | 0 | v0.3.0: garbage "999.2A0", LED off. v1.0.0: OL, LED on
Over range | 2 | CH1 current back to 0.72 A | |12.030V 0.720A0| | |12.030V 0.720A0| | 11 | 0 | |12.030V 0.720A | | |12.030V 0.720A | | 11 | 0 | v0.3.0 keeps a stale "0" in column 15
Over range | 3 | CH1 voltage ADC 1023 (full scale) | |12.030V 0.720A0| | |20.130V 0.720A0| | 11 | 0 | |12.030V 0.720A | | | OL 0.720A | | 11 | 0 | v0.3.0 shows 20.130V for an unknown voltage
Over range | 4 | CH1 voltage back to 12.03 V | |12.030V 0.720A0| | |12.030V 0.720A0| | 11 | 0 | |12.030V 0.720A | | |12.030V 0.720A | | 11 | 0
Over range | 5 | CH1 voltage and current both over range | |12.030V 0.720A0| | |20.130V 999.2A0| | 01 | 0 | |12.030V 0.720A | | | OL OL | | 11 | 0
Over range | 6 | Both back to normal | |12.030V 0.720A0| | |12.030V 0.720A0| | 11 | 0 | |12.030V 0.720A | | |12.030V 0.720A | | 11 | 0
Over range | 7 | CH1 current ADC 911 (5.00 A, last table value) | |12.030V 0.720A0| | |12.030V 5.000A0| | 11 | 0 | |12.030V 0.720A | | |12.030V 5.000A | | 11 | 0
Over range | 8 | CH1 current ADC 912 (first code above 5.00 A) | |12.030V 0.720A0| | |12.030V 999.2A0| | 01 | 0 | |12.030V 0.720A | | |12.030V OL | | 11 | 0
LED | 0 | CH1 current ADC 0 (0.00 A); CH2 ADC 254 / 0 A | |5.0100V 0.000A0| | |12.030V 0.000A0| | 00 | 0 | | 5.020V 0.000A | | |12.030V 0.000A | | 00 | 0
LED | 1 | CH1 current ADC 1 (0.00 A (0.005 A, rounds to 0)); CH2 ADC 254 / 0 A | |5.0100V 0.000A0| | |12.030V 0.000A0| | 00 | 0 | | 5.020V 0.000A | | |12.030V 0.000A | | 00 | 0
LED | 2 | CH1 current ADC 2 (0.01 A); CH2 ADC 254 / 0 A | |5.0100V 0.000A0| | |12.030V 0.010A0| | 10 | 0 | | 5.020V 0.000A | | |12.030V 0.010A | | 10 | 0
LED | 3 | CH1 current ADC 3 (0.01 A); CH2 ADC 254 / 0 A | |5.0100V 0.000A0| | |12.030V 0.010A0| | 10 | 0 | | 5.020V 0.000A | | |12.030V 0.010A | | 10 | 0
LED | 4 | CH1 current ADC 911 (5.00 A); CH2 ADC 254 / 0 A | |5.0100V 0.000A0| | |12.030V 5.000A0| | 10 | 0 | | 5.020V 0.000A | | |12.030V 5.000A | | 10 | 0
LED | 5 | CH1 current ADC 912 (above 5.00 A); CH2 ADC 254 / 0 A | |5.0100V 0.000A0| | |12.030V 999.2A0| | 00 | 0 | | 5.020V 0.000A | | |12.030V OL | | 10 | 0 | v0.3.0 LED off above 5.00 A; v1.0.0 LED on
LED | 6 | CH1 current ADC 1023 (ADC full scale); CH2 ADC 254 / 0 A | |5.0100V 0.000A0| | |12.030V 999.2A0| | 00 | 0 | | 5.020V 0.000A | | |12.030V OL | | 10 | 0 | v0.3.0 LED off above 5.00 A; v1.0.0 LED on
LED | 7 | CH1 current ADC 0 (0.00 A); CH2 ADC 254 / 0 A | |5.0100V 0.000A0| | |12.030V 0.000A0| | 00 | 0 | | 5.020V 0.000A | | |12.030V 0.000A | | 00 | 0
Temperature | 0 | Temperature pin 0.645 V (ADC 132) | |5.0100V 0.000A0| | |12.030V 0.720A0| | 10 | 0 | | 5.020V 0.000A | | |12.030V 0.720A | | 10 | 0
Temperature | 1 | Temperature pin 0.645 V (ADC 132) | |5.0100V 0.000A0| | |12.030V 0.720A0| | 10 | 0 | | 5.020V 0.000A | | |12.030V 0.720A | | 10 | 0
Temperature | 2 | Temperature pin 0.684 V (ADC 140) | | IC6-TEMP | | | ALERT | | 10 | 1 | | VREF-TEMP | | | ALERT | | 10 | 1 | Alert on in both
Temperature | 3 | Temperature pin 0.684 V (ADC 140) | | IC6-TEMP | | | ALERT | | 10 | 1 | | VREF-TEMP | | | ALERT | | 10 | 0
Temperature | 4 | Temperature pin 0.679 V (ADC 139) | |5.0100V-T0.000A | | |12.030VLE0.720A | | 10 | 0 | | VREF-TEMP | | | ALERT | | 10 | 0 | v0.3.0 alert off at 0.679 V and leftover "-T" / "LE"; v1.0.0 stays in alert (hysteresis)
Temperature | 5 | Temperature pin 0.674 V (ADC 138) | |5.0100V-T0.000A | | |12.030VLE0.720A | | 10 | 0 | | VREF-TEMP | | | ALERT | | 10 | 0
Temperature | 6 | Temperature pin 0.679 V (ADC 139) | |5.0100V-T0.000A | | |12.030VLE0.720A | | 10 | 0 | | VREF-TEMP | | | ALERT | | 10 | 0
Temperature | 7 | Temperature pin 0.684 V (ADC 140) | | IC6-TEMP | | | ALERT | | 10 | 1 | | VREF-TEMP | | | ALERT | | 10 | 0
Temperature | 8 | Temperature pin 0.674 V (ADC 138) | |5.0100V-T0.000A | | |12.030VLE0.720A | | 10 | 0 | | VREF-TEMP | | | ALERT | | 10 | 0
Temperature | 9 | Temperature pin 0.669 V (ADC 137) | |5.0100V-T0.000A | | |12.030VLE0.720A | | 10 | 0 | | 5.020V 0.000A | | |12.030V 0.720A | | 10 | 1 | v1.0.0 alert off below 0.670 V; screen cleared once, clean rows
Temperature | 10 | Temperature pin 0.664 V (ADC 136) | |5.0100V-T0.000A | | |12.030VLE0.720A | | 10 | 0 | | 5.020V 0.000A | | |12.030V 0.720A | | 10 | 0
Temperature | 11 | Temperature pin 0.645 V (ADC 132) | |5.0100V-T0.000A | | |12.030VLE0.720A | | 10 | 0 | | 5.020V 0.000A | | |12.030V 0.720A | | 10 | 0
Temperature | 12 | Temperature pin 0.645 V (ADC 132) | |5.0100V-T0.000A | | |12.030VLE0.720A | | 10 | 0 | | 5.020V 0.000A | | |12.030V 0.720A | | 10 | 0
Temperature | 13 | Temperature pin 0.684 V (ADC 140) | | IC6-TEMP | | | ALERT | | 10 | 1 | | VREF-TEMP | | | ALERT | | 10 | 1 | Hovering 140/139: v0.3.0 toggles every cycle; v1.0.0 stays in alert
Temperature | 14 | Temperature pin 0.679 V (ADC 139) | |5.0100V-T0.000A | | |12.030VLE0.720A | | 10 | 0 | | VREF-TEMP | | | ALERT | | 10 | 0 | Hovering 140/139: v0.3.0 toggles every cycle; v1.0.0 stays in alert
Temperature | 15 | Temperature pin 0.684 V (ADC 140) | | IC6-TEMP | | | ALERT | | 10 | 1 | | VREF-TEMP | | | ALERT | | 10 | 0 | Hovering 140/139: v0.3.0 toggles every cycle; v1.0.0 stays in alert
Temperature | 16 | Temperature pin 0.679 V (ADC 139) | |5.0100V-T0.000A | | |12.030VLE0.720A | | 10 | 0 | | VREF-TEMP | | | ALERT | | 10 | 0 | Hovering 140/139: v0.3.0 toggles every cycle; v1.0.0 stays in alert
Temperature | 17 | Temperature pin 0.645 V (ADC 132) | |5.0100V-T0.000A | | |12.030VLE0.720A | | 10 | 0 | | 5.020V 0.000A | | |12.030V 0.720A | | 10 | 1
Crosstalk | 0 | Model: first 0 read(s) after a channel switch return the previous channel value; CH1 17.70 V / 0.72 A | |5.0100V-T0.000A | | |17.700VLE0.720A | | 10 | 0 | | 5.020V 0.000A | | |17.700V 0.720A | | 10 | 0
Crosstalk | 1 | Model: first 1 read(s) after a channel switch return the previous channel value; CH1 17.70 V / 0.72 A | |5.0100V-T0.000A | | |17.700VLE0.720A | | 10 | 0 | | 5.020V 0.000A | | |17.700V 0.720A | | 10 | 0
Crosstalk | 2 | Model: first 2 read(s) after a channel switch return the previous channel value; CH1 17.70 V / 0.72 A | |0.0000V-T0.000A | | |0.0000VLE0.000A | | 00 | 0 | | 5.020V 0.000A | | |17.700V 0.720A | | 10 | 0 | v0.3.0 wrong: it discards only 1 read
Note: the v0.3.0 rows in the Crosstalk block still carry the "-T" / "LE" leftovers from the temperature test before it; v0.3.0 never clears them.
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
