marcosbuydid/dc-dc-power-supply/Module_5/smart_fan_temperature_controller_fw_v1.0.0_verification.xlsx

Sheet: Summary
Smart Fan Temperature Controller – firmware v1.0.0 production verification
Compared against the previous firmware v0.2.1 (smart_fan_temperature_controller_fw_v0.2.1.ino, released January 2024). Target: ATmega328P @ 16 MHz.
Firmware file | smart_fan_temperature_controller_fw_v1.0.0.ino
Reference firmware | smart_fan_temperature_controller_fw_v0.2.1.ino (v0.2.1, released January 2024)
Build – production (DEBUG_FLAG 0) | 6,422 bytes flash (19.6 %), 216 bytes RAM (10.5 %) – avr-gcc, Arduino AVR core, no warnings
Build – debug (DEBUG_FLAG 1) | 8,280 bytes flash (25.3 %), 232 bytes RAM (11.3 %) – no warnings
Verification method | Both sketches were executed unmodified on a host PC with an Arduino/AVR emulation layer (registers, pins, ADC, FG interrupt, buzzer, serial). Only change for v0.2.1: its lookup array declared as int16_t so sizeof() matches the 2-byte AVR int. Values in gray cells are firmware outputs; white cells are Excel formulas cross-checking them.
Not covered | Analogue hardware (sensor accuracy, AREF stability, supply noise) and real fan behaviour – these require bench testing.
Test sheet | Cases | Identical / OK | Intended change | Different / check | Result
Temp_to_PWM | 471 | 460 | 10 | 1 | Only difference: exact 5.000 °C (unreachable from sensors). All v1.0.0 values match the formula.
Sensor_Inputs | 17 | 14 | 3 | 0 | Differences are the dead-zone fix and the new divergence detection.
LED_Alarm_Matrix | 28 | 14 | 14 | 0 | Changes = D6 for failed fan test, sustained-max alarm, divergence LED.
Fan_Startup_Test | 16 | 16 | 0 | 0 | Same pass window (53–56 pulses) as v0.2.1.
ADC_Sweep | 1048576 | 1002064 | 46512 | 0 | Match: identical to v0.2.1 for every valid reading
Sequences | 48 | – | – | – | 8 time sequences incl. over-temperature, sensor failure, fan stall, divergence, known limitation
Watchdog_Timing | 2 | 2 | 0 | 0 | Worst-case loop well below 8 s in production and debug.
Verdict
v1.0.0 regulates the fan exactly like v0.2.1 for every real sensor reading, fixes the 26–27 °C dead zone, and adds sensor-divergence detection, sustained-max-PWM alarm and watchdog protection. Remaining open items are cosmetic comments only (see Corrections_Log). Firmware is ready for production; confirm with bench tests on the target hardware.
Legend
Blue text | Test input / stimulus or firmware constant
Gray fill | Value produced by running the firmware
White, black text | Excel formula (cross-check)
Yellow header | v0.2.1 firmware columns (previous firmware)
Green | Identical / OK
Amber | Intended change or fix
Red | Unexpected difference (none remaining)

Sheet: Constants
Firmware constants used by the checks
Blue = values copied from smart_fan_temperature_controller_fw_v1.0.0.ino (line numbers in column E). Every formula in this workbook references these cells.
Constant | Value | Unit | Meaning | Source
PWM_TOP | 320 | counts | Timer1 TOP (ICR1) – 100 % duty | v1.0.0 line 53
PWM_AT_MINIMUM_TEMPERATURE | 5 | counts | PWM at 5 °C | line 55
PWM_STEP_PER_DEGREE | 7 | counts/°C | PWM increase per °C | line 58
CELSIUS_MINIMUM_TEMPERATURE | 5 | °C | Lower valid temperature (inclusive) | line 37
CELSIUS_MAXIMUM_TEMPERATURE | 50 | °C | Upper valid temperature (inclusive) | line 38
MAX_SENSOR_DIVERGENCE_CELSIUS | 5 | °C | Max allowed difference LM35 vs LM34 (strictly greater = error) | line 44
TEMPERATURE_PWM_ERROR | -1 | code | v1.0.0 code: temperature out of range | line 61
TEMPERATURE_DIVERGENCE_ERROR | -2 | code | v1.0.0 code: sensors disagree | line 64
v0.2.1 error sentinel | 15797 | code | v0.2.1 code: out of range / not found | v0.2.1 temperatureToPwm()
FAN_TEST_MINIMUM_PULSES | 52 | pulses | Fan test passes if pulses > this value | line 71
FAN_TEST_MAXIMUM_PULSES | 57 | pulses | Fan test passes if pulses < this value | line 72
FAN_TEST_PWM | 128 | counts | PWM during fan test (40 % duty) | line 69
FAN_TEST_INITIAL_DELAY_MS | 300 | ms | Delay before fan test | line 75
FAN_TEST_SPINUP_MS | 3000 | ms | Fan spin-up time | line 78
FAN_TEST_COUNT_WINDOW_MS | 1000 | ms | FG pulse counting window | line 81
SETUP_DELAY_MS | 1000 | ms | Delay at end of setup (fan coast-down) | line 91
LOOP_DELAY_MS | 5000 | ms | Main loop period | line 95
BUZZER_BEEP_ON_MS | 500 | ms | Beep length | line 86
BUZZER_BEEP_OFF_MS | 50 | ms | Gap between the two beeps | line 87
MAX_PWM_THRESHOLD | 320 | counts | PWM regarded as maximum fan speed | line 100
MAX_HIGH_PWM_CYCLES | 2 | cycles | Consecutive max-PWM cycles before alarm | line 103
Watchdog timeout (WDTO_8S) | 8000 | ms | Nominal watchdog timeout | line 171
ADC_TO_VOLTAGE_FACTOR | 410.3 | counts/V | 1023 / 2.493 V AREF | line 26
SENSOR_MV_PER_DEGREE | 0.01 | V/degree | LM35 / LM34 scale | line 30
FAHRENHEIT_TO_CELSIUS_CONVERSION_FACTOR | 0.5555 | – | ≈ 5/9 | line 33
RPM per FG pulse per second | 30 | rpm | 2 FG pulses per revolution → pulses/s × 60 / 2 | line 118 comment

Sheet: Temp_to_PWM
Temperature → fan PWM, every 0.1 °C from 4.0 to 51.0 °C
Function-level test: the average temperature is passed directly to temperatureToPWM() (v1.0.0) and temperatureToPwm() (v0.2.1). Gray = firmware output, white = Excel cross-check formula.
Avg temp °C | v0.2.1 PWM | v1.0.0 PWM | Expected v1.0.0 (formula) | v1.0.0 vs formula | v1.0.0 duty % | v1.0.0 vs v0.2.1 | Note
4.0 | 15797 | -1 | -1 | OK | n/a | Both error | Out of range: fan keeps last good PWM, board LED D4 ON
4.1 | 15797 | -1 | -1 | OK | n/a | Both error | Out of range: fan keeps last good PWM, board LED D4 ON
4.2 | 15797 | -1 | -1 | OK | n/a | Both error | Out of range: fan keeps last good PWM, board LED D4 ON
4.3 | 15797 | -1 | -1 | OK | n/a | Both error | Out of range: fan keeps last good PWM, board LED D4 ON
4.4 | 15797 | -1 | -1 | OK | n/a | Both error | Out of range: fan keeps last good PWM, board LED D4 ON
4.5 | 15797 | -1 | -1 | OK | n/a | Both error | Out of range: fan keeps last good PWM, board LED D4 ON
4.6 | 15797 | -1 | -1 | OK | n/a | Both error | Out of range: fan keeps last good PWM, board LED D4 ON
4.7 | 15797 | -1 | -1 | OK | n/a | Both error | Out of range: fan keeps last good PWM, board LED D4 ON
4.8 | 15797 | -1 | -1 | OK | n/a | Both error | Out of range: fan keeps last good PWM, board LED D4 ON
4.9 | 15797 | -1 | -1 | OK | n/a | Both error | Out of range: fan keeps last good PWM, board LED D4 ON
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
50.0 | 320 | 320 | 320 | OK | 100.0% | Identical
50.1 | 15797 | -1 | -1 | OK | n/a | Both error | Out of range: fan keeps last good PWM, board LED D4 ON
50.2 | 15797 | -1 | -1 | OK | n/a | Both error | Out of range: fan keeps last good PWM, board LED D4 ON
50.3 | 15797 | -1 | -1 | OK | n/a | Both error | Out of range: fan keeps last good PWM, board LED D4 ON
50.4 | 15797 | -1 | -1 | OK | n/a | Both error | Out of range: fan keeps last good PWM, board LED D4 ON
50.5 | 15797 | -1 | -1 | OK | n/a | Both error | Out of range: fan keeps last good PWM, board LED D4 ON
50.6 | 15797 | -1 | -1 | OK | n/a | Both error | Out of range: fan keeps last good PWM, board LED D4 ON
50.7 | 15797 | -1 | -1 | OK | n/a | Both error | Out of range: fan keeps last good PWM, board LED D4 ON
50.8 | 15797 | -1 | -1 | OK | n/a | Both error | Out of range: fan keeps last good PWM, board LED D4 ON
50.9 | 15797 | -1 | -1 | OK | n/a | Both error | Out of range: fan keeps last good PWM, board LED D4 ON
51.0 | 15797 | -1 | -1 | OK | n/a | Both error | Out of range: fan keeps last good PWM, board LED D4 ON

Sheet: Sensor_Inputs
Sensor input cases (raw ADC values → temperature → PWM)
Both firmwares run calculateAverageTemperatureFromSensors()/temperatureFromSensors() and the PWM mapping on the same ADC counts.
# | Case | ADC A0 (LM35) | ADC A1 (LM34) | LM35 °C (formula) | LM34 °F (formula) | LM34 as °C (formula) | |LM35 − LM34| °C | Divergence > limit? | v0.2.1 avg °C | v0.2.1 PWM | v1.0.0 avg / sentinel | v1.0.0 PWM code | v1.0.0 result | v1.0.0 vs v0.2.1 | v1.0.0 fan behaviour
1 | Normal 25 °C, sensors agree | 103 | 316 | 25.10 | 77.02 | 25.01 | 0.10 | no | 25.06 | 152 | 25.06 | 152 | Valid | Identical | OCR1A = 152 (48%)
2 | Normal 30 °C, sensors agree | 123 | 353 | 29.98 | 86.03 | 30.02 | 0.04 | no | 30.00 | 180 | 30.00 | 180 | Valid | Identical | OCR1A = 180 (56%)
3 | Normal 45 °C, sensors agree | 185 | 464 | 45.09 | 113.09 | 45.04 | 0.04 | no | 45.07 | 292 | 45.07 | 292 | Valid | Identical | OCR1A = 292 (91%)
4 | Lower valid edge (~5.2 °C) | 21 | 170 | 5.12 | 41.43 | 5.24 | 0.12 | no | 5.18 | 12 | 5.18 | 12 | Valid | Identical | OCR1A = 12 (04%)
5 | Upper valid edge (~49.9 °C) | 205 | 500 | 49.96 | 121.86 | 49.92 | 0.05 | no | 49.94 | 320 | 49.94 | 320 | Valid | Identical | OCR1A = 320 (100%)
6 | Old dead zone (~26.5 °C) | 109 | 327 | 26.57 | 79.70 | 26.50 | 0.07 | no | 26.53 | 15797 | 26.53 | 159 | Valid | Fixed in v1.0.0 | OCR1A = 159 (50%)
7 | Below range (~3.9 °C) | 16 | 160 | 3.90 | 39.00 | 3.89 | 0.01 | n/a (out of range) | -99.14 | 15797 | -99.00 | -1 | Out of range | Both error | Holds last good PWM, D4 ON
8 | Above range (~51 °C) | 210 | 509 | 51.18 | 124.06 | 51.14 | 0.05 | n/a (out of range) | -99.14 | 15797 | -99.00 | -1 | Out of range | Both error | Holds last good PWM, D4 ON
9 | LM35 slightly below range, LM34 valid | 20 | 172 | 4.87 | 41.92 | 5.51 | 0.64 | n/a (out of range) | -99.14 | 15797 | -99.00 | -1 | Out of range | Both error | Holds last good PWM, D4 ON
10 | Divergence just under limit (~4.97 °C apart) | 123 | 316 | 29.98 | 77.02 | 25.01 | 4.97 | no | 27.49 | 166 | 27.49 | 166 | Valid | Identical | OCR1A = 166 (52%)
11 | Divergence just over limit (~5.11 °C apart) | 123 | 315 | 29.98 | 76.77 | 24.87 | 5.11 | YES | 27.42 | 166 | -97.00 | -2 | Sensor divergence | New: divergence detected | Holds last good PWM, D4 ON
12 | Large divergence (30 °C vs 40 °C) | 123 | 427 | 29.98 | 104.07 | 40.03 | 10.06 | YES | 35.01 | 222 | -97.00 | -2 | Sensor divergence | New: divergence detected | Holds last good PWM, D4 ON
13 | LM35 unplugged / reads 0 | 0 | 353 | 0.00 | 86.03 | 30.02 | 30.02 | n/a (out of range) | -99.14 | 15797 | -99.00 | -1 | Out of range | Both error | Holds last good PWM, D4 ON
14 | LM34 unplugged / reads 0 | 123 | 0 | 29.98 | 0.00 | -17.78 | 47.75 | n/a (out of range) | -99.14 | 15797 | -99.00 | -1 | Out of range | Both error | Holds last good PWM, D4 ON
15 | Both sensors unplugged | 0 | 0 | 0.00 | 0.00 | -17.78 | 17.78 | n/a (out of range) | -99.14 | 15797 | -99.00 | -1 | Out of range | Both error | Holds last good PWM, D4 ON
16 | LM35 shorted to AREF (ADC 1023) | 1023 | 353 | 249.33 | 86.03 | 30.02 | 219.31 | n/a (out of range) | -99.14 | 15797 | -99.00 | -1 | Out of range | Both error | Holds last good PWM, D4 ON
17 | LM34 shorted to AREF (ADC 1023) | 123 | 1023 | 29.98 | 249.33 | 120.73 | 90.75 | n/a (out of range) | -99.14 | 15797 | -99.00 | -1 | Out of range | Both error | Holds last good PWM, D4 ON

Sheet: LED_Alarm_Matrix
LED and buzzer outputs for every combination of fan test × temperature × fan rotation
Full firmware run: setup() with the fan test, then loop() cycles leading to the condition. Values are the outputs after the last cycle. D6 = fan status LED, D4 = board status LED.
# | Fan startup test | Temperature condition | Fan rotation (last 5 s) | v1.0.0 PWM code | v1.0.0 OCR1A | v1.0.0 D6 fan LED | v1.0.0 D4 board LED | v1.0.0 buzzer | v0.2.1 PWM | v0.2.1 OCR1A | v0.2.1 D6 | v0.2.1 D4 | v0.2.1 buzzer | LEDs/buzzer vs v0.2.1 | Explanation (v1.0.0)
1 | PASSED | Normal 30 °C | Spinning | 180 | 180 | OFF | OFF | OFF | 180 | 180 | OFF | OFF | OFF | Same | D6: off. D4: off. Buzzer: off.
2 | PASSED | Normal 30 °C | Stopped (0 pulses) | 180 | 180 | ON | OFF | ON | 180 | 180 | ON | OFF | ON | Same | D6: fan stopped. D4: off. Buzzer: fan stopped.
3 | PASSED | Max temp – 1st cycle at PWM 320 (49.8 °C) | Spinning | 320 | 320 | OFF | OFF | OFF | 320 | 320 | OFF | OFF | OFF | Same | D6: off. D4: off. Buzzer: off.
4 | PASSED | Max temp – 1st cycle at PWM 320 (49.8 °C) | Stopped (0 pulses) | 320 | 320 | ON | OFF | ON | 320 | 320 | ON | OFF | ON | Same | D6: fan stopped. D4: off. Buzzer: fan stopped.
5 | PASSED | Max temp – 2nd consecutive cycle (sustained) | Spinning | 320 | 320 | OFF | ON | ON | 320 | 320 | OFF | OFF | OFF | Changed: D4 buzzer | D6: off. D4: sustained max PWM. Buzzer: sustained max PWM.
6 | PASSED | Max temp – 2nd consecutive cycle (sustained) | Stopped (0 pulses) | 320 | 320 | ON | ON | ON | 320 | 320 | ON | OFF | ON | Changed: D4 | D6: fan stopped. D4: sustained max PWM. Buzzer: fan stopped, sustained max PWM.
7 | PASSED | Above 50 °C after sustained max | Spinning | -1 | 320 | OFF | ON | ON | 15797 | 320 | OFF | ON | OFF | Changed: buzzer | D6: off. D4: temperature out of range, sustained max PWM. Buzzer: sustained max PWM. Fan holds last good PWM (320).
8 | PASSED | Above 50 °C after sustained max | Stopped (0 pulses) | -1 | 320 | ON | ON | ON | 15797 | 320 | ON | ON | ON | Same | D6: fan stopped. D4: temperature out of range, sustained max PWM. Buzzer: fan stopped, sustained max PWM. Fan holds last good PWM (320).
9 | PASSED | Above 50 °C reached directly from 45 °C | Spinning | -1 | 292 | OFF | ON | OFF | 15797 | 292 | OFF | ON | OFF | Same | D6: off. D4: temperature out of range. Buzzer: off. Fan holds last good PWM (292). Known limitation: max-PWM counter never started, so no buzzer unless the fan stops.
10 | PASSED | Above 50 °C reached directly from 45 °C | Stopped (0 pulses) | -1 | 292 | ON | ON | ON | 15797 | 292 | ON | ON | ON | Same | D6: fan stopped. D4: temperature out of range. Buzzer: fan stopped. Fan holds last good PWM (292). Known limitation: max-PWM counter never started, so no buzzer unless the fan stops.
11 | PASSED | Sensor unplugged (out of range) | Spinning | -1 | 180 | OFF | ON | OFF | 15797 | 180 | OFF | ON | OFF | Same | D6: off. D4: temperature out of range. Buzzer: off. Fan holds last good PWM (180).
12 | PASSED | Sensor unplugged (out of range) | Stopped (0 pulses) | -1 | 180 | ON | ON | ON | 15797 | 180 | ON | ON | ON | Same | D6: fan stopped. D4: temperature out of range. Buzzer: fan stopped. Fan holds last good PWM (180).
13 | PASSED | Sensor divergence (30 vs 40 °C) | Spinning | -2 | 180 | OFF | ON | OFF | 222 | 222 | OFF | OFF | OFF | Changed: D4 | D6: off. D4: sensor divergence. Buzzer: off. Fan holds last good PWM (180).
14 | PASSED | Sensor divergence (30 vs 40 °C) | Stopped (0 pulses) | -2 | 180 | ON | ON | ON | 222 | 222 | ON | OFF | ON | Changed: D4 | D6: fan stopped. D4: sensor divergence. Buzzer: fan stopped. Fan holds last good PWM (180).
15 | NOT PASSED | Normal 30 °C | Spinning | 180 | 180 | ON | OFF | OFF | 180 | 180 | OFF | ON | OFF | Changed: D6 D4 | D6: fan test failed. D4: off. Buzzer: off.
16 | NOT PASSED | Normal 30 °C | Stopped (0 pulses) | 180 | 180 | ON | OFF | ON | 180 | 180 | ON | ON | ON | Changed: D4 | D6: fan test failed, fan stopped. D4: off. Buzzer: fan stopped.
17 | NOT PASSED | Max temp – 1st cycle at PWM 320 (49.8 °C) | Spinning | 320 | 320 | ON | OFF | OFF | 320 | 320 | OFF | ON | OFF | Changed: D6 D4 | D6: fan test failed. D4: off. Buzzer: off.
18 | NOT PASSED | Max temp – 1st cycle at PWM 320 (49.8 °C) | Stopped (0 pulses) | 320 | 320 | ON | OFF | ON | 320 | 320 | ON | ON | ON | Changed: D4 | D6: fan test failed, fan stopped. D4: off. Buzzer: fan stopped.
19 | NOT PASSED | Max temp – 2nd consecutive cycle (sustained) | Spinning | 320 | 320 | ON | ON | ON | 320 | 320 | OFF | ON | OFF | Changed: D6 buzzer | D6: fan test failed. D4: sustained max PWM. Buzzer: sustained max PWM.
20 | NOT PASSED | Max temp – 2nd consecutive cycle (sustained) | Stopped (0 pulses) | 320 | 320 | ON | ON | ON | 320 | 320 | ON | ON | ON | Same | D6: fan test failed, fan stopped. D4: sustained max PWM. Buzzer: fan stopped, sustained max PWM.
21 | NOT PASSED | Above 50 °C after sustained max | Spinning | -1 | 320 | ON | ON | ON | 15797 | 320 | OFF | ON | OFF | Changed: D6 buzzer | D6: fan test failed. D4: temperature out of range, sustained max PWM. Buzzer: sustained max PWM. Fan holds last good PWM (320).
22 | NOT PASSED | Above 50 °C after sustained max | Stopped (0 pulses) | -1 | 320 | ON | ON | ON | 15797 | 320 | ON | ON | ON | Same | D6: fan test failed, fan stopped. D4: temperature out of range, sustained max PWM. Buzzer: fan stopped, sustained max PWM. Fan holds last good PWM (320).
23 | NOT PASSED | Above 50 °C reached directly from 45 °C | Spinning | -1 | 292 | ON | ON | OFF | 15797 | 292 | OFF | ON | OFF | Changed: D6 | D6: fan test failed. D4: temperature out of range. Buzzer: off. Fan holds last good PWM (292). Known limitation: max-PWM counter never started, so no buzzer unless the fan stops.
24 | NOT PASSED | Above 50 °C reached directly from 45 °C | Stopped (0 pulses) | -1 | 292 | ON | ON | ON | 15797 | 292 | ON | ON | ON | Same | D6: fan test failed, fan stopped. D4: temperature out of range. Buzzer: fan stopped. Fan holds last good PWM (292). Known limitation: max-PWM counter never started, so no buzzer unless the fan stops.
25 | NOT PASSED | Sensor unplugged (out of range) | Spinning | -1 | 180 | ON | ON | OFF | 15797 | 180 | OFF | ON | OFF | Changed: D6 | D6: fan test failed. D4: temperature out of range. Buzzer: off. Fan holds last good PWM (180).
26 | NOT PASSED | Sensor unplugged (out of range) | Stopped (0 pulses) | -1 | 180 | ON | ON | ON | 15797 | 180 | ON | ON | ON | Same | D6: fan test failed, fan stopped. D4: temperature out of range. Buzzer: fan stopped. Fan holds last good PWM (180).
27 | NOT PASSED | Sensor divergence (30 vs 40 °C) | Spinning | -2 | 180 | ON | ON | OFF | 222 | 222 | OFF | ON | OFF | Changed: D6 | D6: fan test failed. D4: sensor divergence. Buzzer: off. Fan holds last good PWM (180).
28 | NOT PASSED | Sensor divergence (30 vs 40 °C) | Stopped (0 pulses) | -2 | 180 | ON | ON | ON | 222 | 222 | ON | ON | ON | Same | D6: fan test failed, fan stopped. D4: sensor divergence. Buzzer: fan stopped. Fan holds last good PWM (180).

Sheet: Sequences
Time sequences (full firmware, cycle by cycle)
Each sequence starts with setup() (fan test PASSED) followed by loop() cycles. Elapsed time uses v1.0.0 timing: loop delay + alarm duration when the buzzer sounded in the previous cycle.
Seq | Scenario | Step | Elapsed s | Input condition | FG pulses (last 5 s) | LM35 °C | LM34 °F | v1.0.0 avg / sentinel | v1.0.0 PWM code | v1.0.0 OCR1A | v1.0.0 max-PWM counter | v1.0.0 D4 | v1.0.0 D6 | v1.0.0 buzzer | v0.2.1 PWM | v0.2.1 OCR1A | v0.2.1 D4 | v0.2.1 D6 | v0.2.1 buzzer | What happens (v1.0.0)
Sequence A – Normal heat-up and cool-down
A | Normal heat-up and cool-down | 1 | 0.00 | 25.0 °C | 400 | 25.10 | 77.02 | 25.06 | 152 | 152 | 0 | OFF | OFF | OFF | 152 | 152 | OFF | OFF | OFF | Normal regulation
A | Normal heat-up and cool-down | 2 | 5.00 | 35.0 °C | 400 | 35.10 | 95.05 | 35.06 | 222 | 222 | 0 | OFF | OFF | OFF | 222 | 222 | OFF | OFF | OFF | Normal regulation
A | Normal heat-up and cool-down | 3 | 10.00 | 45.0 °C | 400 | 45.09 | 113.09 | 45.07 | 292 | 292 | 0 | OFF | OFF | OFF | 292 | 292 | OFF | OFF | OFF | Normal regulation
A | Normal heat-up and cool-down | 4 | 15.00 | 48.0 °C | 400 | 48.01 | 118.45 | 48.02 | 313 | 313 | 0 | OFF | OFF | OFF | 313 | 313 | OFF | OFF | OFF | Normal regulation
A | Normal heat-up and cool-down | 5 | 20.00 | 49.2 °C | 400 | 49.23 | 120.64 | 49.24 | 320 | 320 | 1 | OFF | OFF | OFF | 320 | 320 | OFF | OFF | OFF | 1st cycle at PWM 320 → counter = 1, no alarm yet
A | Normal heat-up and cool-down | 6 | 25.00 | 49.8 °C | 400 | 49.72 | 121.62 | 49.75 | 320 | 320 | 2 | ON | OFF | ON | 320 | 320 | OFF | OFF | OFF | 2nd consecutive cycle at PWM 320 → sustained max: D4 ON + buzzer
A | Normal heat-up and cool-down | 7 | 31.05 | 49.8 °C | 400 | 49.72 | 121.62 | 49.75 | 320 | 320 | 2 | ON | OFF | ON | 320 | 320 | OFF | OFF | OFF | Still at max PWM → alarm continues
A | Normal heat-up and cool-down | 8 | 37.10 | 48.0 °C | 400 | 48.01 | 118.45 | 48.02 | 313 | 313 | 0 | OFF | OFF | OFF | 313 | 313 | OFF | OFF | OFF | Valid lower PWM → counter reset, alarm stops
A | Normal heat-up and cool-down | 9 | 42.10 | 40.0 °C | 400 | 39.97 | 104.07 | 40.00 | 257 | 257 | 0 | OFF | OFF | OFF | 257 | 257 | OFF | OFF | OFF | Normal regulation
A | Normal heat-up and cool-down | 10 | 47.10 | 30.0 °C | 400 | 29.98 | 86.03 | 30.00 | 180 | 180 | 0 | OFF | OFF | OFF | 180 | 180 | OFF | OFF | OFF | Normal regulation
Sequence B – Over-temperature above 50 °C
B | Over-temperature above 50 °C | 1 | 0.00 | 45.0 °C | 400 | 45.09 | 113.09 | 45.07 | 292 | 292 | 0 | OFF | OFF | OFF | 292 | 292 | OFF | OFF | OFF | Normal regulation
B | Over-temperature above 50 °C | 2 | 5.00 | 49.8 °C | 400 | 49.72 | 121.62 | 49.75 | 320 | 320 | 1 | OFF | OFF | OFF | 320 | 320 | OFF | OFF | OFF | 1st cycle at PWM 320 → counter = 1, no alarm yet
B | Over-temperature above 50 °C | 3 | 10.00 | 49.8 °C | 400 | 49.72 | 121.62 | 49.75 | 320 | 320 | 2 | ON | OFF | ON | 320 | 320 | OFF | OFF | OFF | 2nd consecutive cycle at PWM 320 → sustained max: D4 ON + buzzer
B | Over-temperature above 50 °C | 4 | 16.05 | 51.0 °C | 400 | 50.94 | 123.81 | -99.00 | -1 | 320 | 2 | ON | OFF | ON | 15797 | 320 | ON | OFF | OFF | Out of range does not reset the counter → alarm kept, fan holds 320
B | Over-temperature above 50 °C | 5 | 22.10 | 53.0 °C | 400 | 52.89 | 127.47 | -99.00 | -1 | 320 | 2 | ON | OFF | ON | 15797 | 320 | ON | OFF | OFF | Out of range does not reset the counter → alarm kept, fan holds 320
B | Over-temperature above 50 °C | 6 | 28.15 | 55.0 °C | 400 | 55.08 | 130.88 | -99.00 | -1 | 320 | 2 | ON | OFF | ON | 15797 | 320 | ON | OFF | OFF | Out of range does not reset the counter → alarm kept, fan holds 320
B | Over-temperature above 50 °C | 7 | 34.20 | 51.0 °C | 400 | 50.94 | 123.81 | -99.00 | -1 | 320 | 2 | ON | OFF | ON | 15797 | 320 | ON | OFF | OFF | Out of range does not reset the counter → alarm kept, fan holds 320
B | Over-temperature above 50 °C | 8 | 40.25 | 49.8 °C | 400 | 49.72 | 121.62 | 49.75 | 320 | 320 | 2 | ON | OFF | ON | 320 | 320 | OFF | OFF | OFF | Still at max PWM → alarm continues
B | Over-temperature above 50 °C | 9 | 46.30 | 48.0 °C | 400 | 48.01 | 118.45 | 48.02 | 313 | 313 | 0 | OFF | OFF | OFF | 313 | 313 | OFF | OFF | OFF | Valid lower PWM → counter reset, alarm stops
B | Over-temperature above 50 °C | 10 | 51.30 | 45.0 °C | 400 | 45.09 | 113.09 | 45.07 | 292 | 292 | 0 | OFF | OFF | OFF | 292 | 292 | OFF | OFF | OFF | Normal regulation
Sequence C – Sensor failure while at maximum PWM
C | Sensor failure while at maximum PWM | 1 | 0.00 | 45.0 °C | 400 | 45.09 | 113.09 | 45.07 | 292 | 292 | 0 | OFF | OFF | OFF | 292 | 292 | OFF | OFF | OFF | Normal regulation
C | Sensor failure while at maximum PWM | 2 | 5.00 | 49.8 °C | 400 | 49.72 | 121.62 | 49.75 | 320 | 320 | 1 | OFF | OFF | OFF | 320 | 320 | OFF | OFF | OFF | 1st cycle at PWM 320 → counter = 1, no alarm yet
C | Sensor failure while at maximum PWM | 3 | 10.00 | 49.8 °C | 400 | 49.72 | 121.62 | 49.75 | 320 | 320 | 2 | ON | OFF | ON | 320 | 320 | OFF | OFF | OFF | 2nd consecutive cycle at PWM 320 → sustained max: D4 ON + buzzer
C | Sensor failure while at maximum PWM | 4 | 16.05 | Sensor unplugged (ADC 0 / 0) | 400 | 0.00 | 0.00 | -99.00 | -1 | 320 | 2 | ON | OFF | ON | 15797 | 320 | ON | OFF | OFF | Out of range does not reset the counter → alarm kept, fan holds 320
C | Sensor failure while at maximum PWM | 5 | 22.10 | Sensor unplugged (ADC 0 / 0) | 400 | 0.00 | 0.00 | -99.00 | -1 | 320 | 2 | ON | OFF | ON | 15797 | 320 | ON | OFF | OFF | Out of range does not reset the counter → alarm kept, fan holds 320
C | Sensor failure while at maximum PWM | 6 | 28.15 | 48.0 °C | 400 | 48.01 | 118.45 | 48.02 | 313 | 313 | 0 | OFF | OFF | OFF | 313 | 313 | OFF | OFF | OFF | Valid lower PWM → counter reset, alarm stops
Sequence D – Sensor failure during normal operation
D | Sensor failure during normal operation | 1 | 0.00 | 30.0 °C | 400 | 29.98 | 86.03 | 30.00 | 180 | 180 | 0 | OFF | OFF | OFF | 180 | 180 | OFF | OFF | OFF | Normal regulation
D | Sensor failure during normal operation | 2 | 5.00 | Sensor unplugged (ADC 0 / 0) | 400 | 0.00 | 0.00 | -99.00 | -1 | 180 | 0 | ON | OFF | OFF | 15797 | 180 | ON | OFF | OFF | Out of range → D4 ON, fan holds last PWM 180
D | Sensor failure during normal operation | 3 | 10.00 | Sensor unplugged (ADC 0 / 0) | 400 | 0.00 | 0.00 | -99.00 | -1 | 180 | 0 | ON | OFF | OFF | 15797 | 180 | ON | OFF | OFF | Out of range → D4 ON, fan holds last PWM 180
D | Sensor failure during normal operation | 4 | 15.00 | 30.0 °C | 400 | 29.98 | 86.03 | 30.00 | 180 | 180 | 0 | OFF | OFF | OFF | 180 | 180 | OFF | OFF | OFF | Normal regulation
Sequence E – Fast jump above 50 °C (known limitation)
E | Fast jump above 50 °C (known limitation) | 1 | 0.00 | 45.0 °C | 400 | 45.09 | 113.09 | 45.07 | 292 | 292 | 0 | OFF | OFF | OFF | 292 | 292 | OFF | OFF | OFF | Normal regulation
E | Fast jump above 50 °C (known limitation) | 2 | 5.00 | 52.0 °C | 400 | 51.91 | 125.52 | -99.00 | -1 | 292 | 0 | ON | OFF | OFF | 15797 | 292 | ON | OFF | OFF | Out of range → D4 ON, fan holds last PWM 292; Known limitation: jumped over 49–50 °C band, counter never started → D4 only, no buzzer
E | Fast jump above 50 °C (known limitation) | 3 | 10.00 | 52.0 °C | 400 | 51.91 | 125.52 | -99.00 | -1 | 292 | 0 | ON | OFF | OFF | 15797 | 292 | ON | OFF | OFF | Out of range → D4 ON, fan holds last PWM 292; Known limitation: jumped over 49–50 °C band, counter never started → D4 only, no buzzer
E | Fast jump above 50 °C (known limitation) | 4 | 15.00 | 52.0 °C | 400 | 51.91 | 125.52 | -99.00 | -1 | 292 | 0 | ON | OFF | OFF | 15797 | 292 | ON | OFF | OFF | Out of range → D4 ON, fan holds last PWM 292; Known limitation: jumped over 49–50 °C band, counter never started → D4 only, no buzzer
E | Fast jump above 50 °C (known limitation) | 5 | 20.00 | 45.0 °C | 400 | 45.09 | 113.09 | 45.07 | 292 | 292 | 0 | OFF | OFF | OFF | 292 | 292 | OFF | OFF | OFF | Normal regulation
Sequence F – Fan stall and recovery
F | Fan stall and recovery | 1 | 0.00 | 30.0 °C | 400 | 29.98 | 86.03 | 30.00 | 180 | 180 | 0 | OFF | OFF | OFF | 180 | 180 | OFF | OFF | OFF | Normal regulation
F | Fan stall and recovery | 2 | 5.00 | 30.0 °C | 0 | 29.98 | 86.03 | 30.00 | 180 | 180 | 0 | OFF | ON | ON | 180 | 180 | OFF | ON | ON | No FG pulses → D6 ON + buzzer
F | Fan stall and recovery | 3 | 11.05 | 30.0 °C | 0 | 29.98 | 86.03 | 30.00 | 180 | 180 | 0 | OFF | ON | ON | 180 | 180 | OFF | ON | ON | No FG pulses → D6 ON + buzzer
F | Fan stall and recovery | 4 | 17.10 | 30.0 °C | 400 | 29.98 | 86.03 | 30.00 | 180 | 180 | 0 | OFF | OFF | OFF | 180 | 180 | OFF | OFF | OFF | Normal regulation
Sequence G – Sensor divergence and recovery
G | Sensor divergence and recovery | 1 | 0.00 | 30.0 °C | 400 | 29.98 | 86.03 | 30.00 | 180 | 180 | 0 | OFF | OFF | OFF | 180 | 180 | OFF | OFF | OFF | Normal regulation
G | Sensor divergence and recovery | 2 | 5.00 | Divergence (ADC 123 / 427 → 30 °C vs 104 °F) | 400 | 29.98 | 104.07 | -97.00 | -2 | 180 | 0 | ON | OFF | OFF | 222 | 222 | OFF | OFF | OFF | Sensors disagree > 5 °C → D4 ON, fan holds last PWM 180 (v0.2.1 would average them)
G | Sensor divergence and recovery | 3 | 10.00 | Divergence (ADC 123 / 427 → 30 °C vs 104 °F) | 400 | 29.98 | 104.07 | -97.00 | -2 | 180 | 0 | ON | OFF | OFF | 222 | 222 | OFF | OFF | OFF | Sensors disagree > 5 °C → D4 ON, fan holds last PWM 180 (v0.2.1 would average them)
G | Sensor divergence and recovery | 4 | 15.00 | 30.0 °C | 400 | 29.98 | 86.03 | 30.00 | 180 | 180 | 0 | OFF | OFF | OFF | 180 | 180 | OFF | OFF | OFF | Normal regulation
Sequence H – Low-temperature edge
H | Low-temperature edge | 1 | 0.00 | 5.2 °C | 400 | 5.12 | 41.43 | 5.18 | 12 | 12 | 0 | OFF | OFF | OFF | 12 | 12 | OFF | OFF | OFF | Normal regulation
H | Low-temperature edge | 2 | 5.00 | 5.6 °C | 400 | 5.61 | 42.16 | 5.63 | 12 | 12 | 0 | OFF | OFF | OFF | 12 | 12 | OFF | OFF | OFF | Normal regulation
H | Low-temperature edge | 3 | 10.00 | 6.0 °C | 400 | 6.09 | 42.90 | 6.07 | 19 | 19 | 0 | OFF | OFF | OFF | 19 | 19 | OFF | OFF | OFF | Normal regulation
H | Low-temperature edge | 4 | 15.00 | 4.8 °C | 400 | 4.87 | 40.70 | -99.00 | -1 | 19 | 0 | ON | OFF | OFF | 15797 | 19 | ON | OFF | OFF | Out of range → D4 ON, fan holds last PWM 19
H | Low-temperature edge | 5 | 20.00 | 7.0 °C | 400 | 7.07 | 44.60 | 7.03 | 26 | 26 | 0 | OFF | OFF | OFF | 26 | 26 | OFF | OFF | OFF | Normal regulation

Sheet: Fan_Startup_Test
Fan startup test – FG pulses counted in the 1 s window
Full setup() run with the FG interrupt firing N times during the counting window (fan at FAN_TEST_PWM = 128).
FG pulses in 1 s | Fan RPM (formula) | Expected result (formula) | v1.0.0 result | v0.2.1 result | v1.0.0 vs expected | v1.0.0 vs v0.2.1 | v1.0.0 indication | v0.2.1 indication | v1.0.0 serial debug output | Interpretation
0 | 0 | NOT PASSED | NOT PASSED | NOT PASSED | OK | Identical | D6 ON permanently | D4 ON permanently | Detected FGPulses: 0 | Test Result: NOT PASSED | Fan not turning, FG line open, or no PWM/12 V to fan
10 | 300 | NOT PASSED | NOT PASSED | NOT PASSED | OK | Identical | D6 ON permanently | D4 ON permanently | Detected FGPulses: 10 | Test Result: NOT PASSED | Fan far too slow – possible stall / bearing fault
30 | 900 | NOT PASSED | NOT PASSED | NOT PASSED | OK | Identical | D6 ON permanently | D4 ON permanently | Detected FGPulses: 30 | Test Result: NOT PASSED | Fan too slow
45 | 1350 | NOT PASSED | NOT PASSED | NOT PASSED | OK | Identical | D6 ON permanently | D4 ON permanently | Detected FGPulses: 45 | Test Result: NOT PASSED | Fan slower than expected (supply voltage low / fan wear)
50 | 1500 | NOT PASSED | NOT PASSED | NOT PASSED | OK | Identical | D6 ON permanently | D4 ON permanently | Detected FGPulses: 50 | Test Result: NOT PASSED | Slightly slow
52 | 1560 | NOT PASSED | NOT PASSED | NOT PASSED | OK | Identical | D6 ON permanently | D4 ON permanently | Detected FGPulses: 52 | Test Result: NOT PASSED | Lower boundary – fails (window is 53…56)
53 | 1590 | PASSED | PASSED | PASSED | OK | Identical | D6 OFF (unless fan stops) | D4 OFF (unless temp error) | Detected FGPulses: 53 | Test Result: PASSED | Lowest passing value
54 | 1620 | PASSED | PASSED | PASSED | OK | Identical | D6 OFF (unless fan stops) | D4 OFF (unless temp error) | Detected FGPulses: 54 | Test Result: PASSED | Healthy fan (typical 53–55)
55 | 1650 | PASSED | PASSED | PASSED | OK | Identical | D6 OFF (unless fan stops) | D4 OFF (unless temp error) | Detected FGPulses: 55 | Test Result: PASSED | Healthy fan (typical 53–55)
56 | 1680 | PASSED | PASSED | PASSED | OK | Identical | D6 OFF (unless fan stops) | D4 OFF (unless temp error) | Detected FGPulses: 56 | Test Result: PASSED | Highest passing value
57 | 1710 | NOT PASSED | NOT PASSED | NOT PASSED | OK | Identical | D6 ON permanently | D4 ON permanently | Detected FGPulses: 57 | Test Result: NOT PASSED | Upper boundary – fails
58 | 1740 | NOT PASSED | NOT PASSED | NOT PASSED | OK | Identical | D6 ON permanently | D4 ON permanently | Detected FGPulses: 58 | Test Result: NOT PASSED | Slightly fast
65 | 1950 | NOT PASSED | NOT PASSED | NOT PASSED | OK | Identical | D6 ON permanently | D4 ON permanently | Detected FGPulses: 65 | Test Result: NOT PASSED | Too fast – PWM signal may be weak/partially lost
100 | 3000 | NOT PASSED | NOT PASSED | NOT PASSED | OK | Identical | D6 ON permanently | D4 ON permanently | Detected FGPulses: 100 | Test Result: NOT PASSED | Much too fast – PWM likely not reaching the fan
130 | 3900 | NOT PASSED | NOT PASSED | NOT PASSED | OK | Identical | D6 ON permanently | D4 ON permanently | Detected FGPulses: 130 | Test Result: NOT PASSED | Full speed: PWM lead disconnected (130–135 per firmware notes)
135 | 4050 | NOT PASSED | NOT PASSED | NOT PASSED | OK | Identical | D6 ON permanently | D4 ON permanently | Detected FGPulses: 135 | Test Result: NOT PASSED | Full speed: PWM lead disconnected (130–135 per firmware notes)

Sheet: ADC_Sweep
Exhaustive sweep: every ADC combination of both sensors (1024 × 1024)
Each combination was processed by both firmwares (average + PWM mapping). Counts are firmware results; percentages and checks are formulas.
Category | Combinations | % of total | Meaning
Both versions report an error (out of range) | 989461 | 94.36% | Neither sensor pair is inside 5–50 °C → both keep last PWM
Valid in both – identical PWM | 12603 | 1.20% | Fan speed exactly the same as v0.2.1
Valid in both – different PWM | 0 | 0.00% | Must be 0 for equivalence
v0.2.1 error → v1.0.0 valid (dead-zone fix) | 304 | 0.03% | v0.2.1 26–27 °C bug fixed
v0.2.1 valid → v1.0.0 divergence error | 46208 | 4.41% | New protection: sensors > 5 °C apart are no longer averaged
Any other difference | 0 | 0.00% | Must be 0
Total combinations | 1048576 | 100.00%
Check: total = 1024 × 1024 | OK
Equivalence verdict | Match: identical to v0.2.1 for every valid reading

Sheet: Watchdog_Timing
Watchdog timing budget
The watchdog is disabled at boot and enabled only at the end of setup(); inside loop() the longest blocking path must stay below the 8 s timeout.
Startup phase (watchdog OFF) | Duration ms | Cumulative ms | Source
Initial delay | 300 | 300 | FAN_TEST_INITIAL_DELAY_MS
Fan spin-up at PWM 128 | 3000 | 3300 | FAN_TEST_SPINUP_MS
FG counting window | 1000 | 4300 | FAN_TEST_COUNT_WINDOW_MS
End-of-setup delay (coast-down) | 1000 | 5300 | SETUP_DELAY_MS
Startup time before wdt_enable() | 5300
Would an 8 s watchdog active during setup survive? | yes
Would the 16 ms post-reset watchdog survive without MCUSR=0 / wdt_disable()? | NO → reset loop
Worst-case loop() path (watchdog ON) | Production ms | Debug ms | Source / assumption
4 × analogRead + float math | 0.5 | 0.5 | Assumption: ~112 µs per analogRead
Fault alarm (2 beeps + 1 gap) | 1050.0 | 1050.0 | triggerFaultAlarm()
Serial debug output (≈190 chars at 9600 baud) | 0.0 | 200.0 | Assumption: worst-case cycle ≈190 characters; compiled out in production
LOOP_DELAY_MS | 5000.0 | 5000.0 | delay(LOOP_DELAY_MS)
Total time between two wdt_reset() calls | 6050.5 | 6250.5
Watchdog timeout | 8000 | 8000
Margin ms | 1949.5 | 1749.5
Margin % | 24.4% | 21.9%
Status | OK | OK
Note: the AVR watchdog oscillator varies with supply voltage and temperature; a margin of about 20 % against the nominal 8 s is acceptable.

Sheet: Serial_Output
Serial monitor output with DEBUG_FLAG 1 (captured from the firmware)
Exact text printed per scenario, in the order it appears. Arduino ends each println with CR+LF. With DEBUG_FLAG 0 nothing is printed.
Scenario | Line | Serial monitor text
Startup – fan test PASSED (55 pulses) | 1 | Detected FGPulses: 55
 | 2 | Test Result: PASSED
Startup – fan test NOT PASSED (0 pulses) | 1 | Detected FGPulses: 0
 | 2 | Test Result: NOT PASSED
Loop – normal 30 °C | 1 | ----- cycle -----
 | 2 | Average Temperature: 30.00
 | 3 | Fan PWM: 180
 | 4 | OCR1A applied: 180
Loop – sensor unplugged | 1 | ----- cycle -----
 | 2 | Temperature out of range
 | 3 | Average Temperature: -99.00
 | 4 | Fan PWM: -1
 | 5 | OCR1A applied: 180
Loop – sensor divergence | 1 | ----- cycle -----
 | 2 | Reading divergence between sensors
 | 3 | Celsius sensor reading: 29.98
 | 4 | Fahrenheit sensor (as C): 40.03
 | 5 | Average Temperature: -97.00
 | 6 | Fan PWM: -2
 | 7 | OCR1A applied: 180
Loop – fan stopped | 1 | ----- cycle -----
 | 2 | Fan not spinning or sustained high pwm detected
 | 3 | Average Temperature: 30.00
 | 4 | Fan PWM: 180
 | 5 | OCR1A applied: 180
Loop – sustained max PWM (2nd cycle) | 1 | ----- cycle -----
 | 2 | Fan not spinning or sustained high pwm detected
 | 3 | Average Temperature: 49.75
 | 4 | Fan PWM: 320
 | 5 | OCR1A applied: 320
Loop – above 50 °C after sustained max | 1 | ----- cycle -----
 | 2 | Temperature out of range
 | 3 | Fan not spinning or sustained high pwm detected
 | 4 | Average Temperature: -99.00
 | 5 | Fan PWM: -1
 | 6 | OCR1A applied: 320
Loop – fan stopped AND sustained max | 1 | ----- cycle -----
 | 2 | Fan not spinning or sustained high pwm detected
 | 3 | Average Temperature: 49.75
 | 4 | Fan PWM: 320
 | 5 | OCR1A applied: 320

Sheet: Changes_vs_v0.2.1
Behaviour differences between v0.2.1 and v1.0.0
Everything not listed here behaves identically (confirmed by the ADC sweep, matrix and sequences).
# | Area | v0.2.1 | v1.0.0 | Impact | Type
1 | Temperature → PWM | Array search; integer division makes it round UP (ceiling) | Direct formula with ceil() | Identical PWM for every real sensor reading | Internal refactor
2 | 26–27 °C range | Returns error for valid temperatures (dead zone) | Correct PWM | No false board-LED error, fan regulated normally | Bug fix
3 | Sensor divergence | Not checked – two disagreeing sensors are averaged | Difference > 5 °C → code −2, D4 ON, fan holds last PWM | Failed or detached sensor is detected | New feature
4 | Sustained maximum PWM | Not detected | 2 consecutive cycles at PWM 320 → D4 ON + buzzer; kept while above 50 °C | Audible warning of thermal overload | New feature
5 | Fan startup test failure | Board LED D4 ON | Fan LED D6 ON | Update service documentation | Behaviour change
6 | FG pulse counter access | Non-atomic 16-bit read/reset | Atomic (interrupts disabled) | No corrupted pulse counts | Bug fix
7 | Pulse counter reset vs alarm | Reset after the ~1.1 s alarm (pulses discarded) | Reset before the alarm | Fan recovery detected one cycle sooner | Behaviour change (minor)
8 | Watchdog | None | Disabled at boot, 8 s enabled after setup, reset every loop | Automatic recovery from a firmware hang | New feature
9 | Serial port | Always initialised | Only with DEBUG_FLAG 1 | No UART overhead in production | Internal
10 | Fan test result storage | String object ("PASSED"/"NOT_PASSED") | bool | Less RAM, no heap use | Internal
11 | Fault alarm duration | 1100 ms (trailing 50 ms gap) | 1050 ms | None audible | Internal
12 | Fan test initial delay | 100 ms | 300 ms | Slightly more settling before the test | Constant change

Sheet: Corrections_Log
Corrections applied during the review
Status verified against the uploaded smart_fan_temperature_controller_fw_v1.0.0.ino.
# | Correction | Location (current file) | Priority | Status
1 | ceil() instead of round() in temperatureToPWM | line 312 | Critical | Done
2 | Divergence check compares temperatures, not booleans | line 286 | Critical | Done
3 | Divergence checked before range check | lines 304–310 | Critical | Done
4 | updateFanPWM rejects negative codes (+ upper bound PWM_TOP) | line 318 | Critical | Done
5 | Max-PWM counter capped; error codes do not reset it | lines 362–370 | Critical | Done
6 | MCUSR = 0; wdt_disable(); at start of setup() | lines 152–153 | Production safety | Done
7 | DEBUG_FLAG moved to top of file | line 11 | Production safety | Done
8 | Cycle separator in serial output | line 178 | Debug | Done
9 | "Fahrenheit sensor (as C)" label | line 291 | Debug | Done
10 | OCR1A applied printed | lines 209–210 | Debug | Done
11 | Alarm debug message printed before the beeps | lines 344–347 | Debug | Done
12 | 16 MHz timer comment | line 52 | Clarity | Done
13 | Temperature variable names in loop() | lines 183–187 | Clarity | Done
14 | High-PWM constants in own section | lines 97–103 | Clarity | Done
15 | countWindowStart (camelCase) | line 227 | Clarity | Done
16 | Fan test comment "more than 56" | line 242 | Clarity | Done
17 | Comment still says round(temperature) – should say ceil | line 302 | Cosmetic | Open (no functional effect)
18 | Counter comment wording ("no overflow after ~55 hours") | line 365 | Cosmetic | Open (no functional effect)
19 | Alarm debug message could name which condition fired | line 345 | Cosmetic | Open (no functional effect)
