marcosbuydid/dc-dc-power-supply/Module_2/current calibration.xlsx

currents posibles | tested with 20.042v | calibrated current (in volts) | calibration point | test calculated current | 0 | 1 | 2 | 3 | 4 | 5 | 6 | 7 | 8 | 9 | 10 | 11 | 12 | 13 | 14 | 15 | 16 | 17 | 18 | 19 | 20 | 21 | 22 | 23 | 24 | 25 | 26 | 27 | 28 | 29 | 30 | 31 | 32 | 33 | 34 | 35 | 36 | 37 | 38 | 39 | 40 | 41 | 42 | 43 | 44 | 45 | 46 | 47 | 48 | 49 | 50 | 51
0 | 0 | 0.000 |  | 0.000 | 0 | 0.012 | 0.021 | 0.03 | 0.039 | 0.048 | 0.057 | 0.066 | 0.075 | 0.084 | 0.093 | 0.102 | 0.111 | 0.119 | 0.128 | 0.137 | 0.146 | 0.155 | 0.164 | 0.173 | 0.182 | 0.191 | 0.201 | 0.209 | 0.218 | 0.227 | 0.236 | 0.245 | 0.254 | 0.263 | 0.272 | 0.281 | 0.289 | 0.298 | 0.307 | 0.316 | 0.325 | 0.334 | 0.343 | 0.352 | 0.361 | 0.37 | 0.379 | 0.388 | 0.397 | 0.406 | 0.415 | 0.424 | 0.433 | 0.442 | 0.45 | 0.459
0.01 | 0.084 | 0.012 |  | 0.013 | 0 | 12 | 21 | 30 | 39 | 48 | 57 | 66 | 75 | 84 | 93 | 102 | 111 | 119 | 128 | 137 | 146 | 155 | 164 | 173 | 182 | 191 | 201 | 209 | 218 | 227 | 236 | 245 | 254 | 263 | 272 | 281 | 289 | 298 | 307 | 316 | 325 | 334 | 343 | 352 | 361 | 370 | 379 | 388 | 397 | 406 | 415 | 424 | 433 | 442 | 450 | 459
0.02 | 0.093 | 0.021 |  | 0.023
0.03 | 0.102 | 0.030 |  | 0.033
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
