marcosbuydid/dc-dc-power-supply/Module_2/voltmeter-calibration-v3.xlsx

 |  |  |  |  |  |  | [index *10 +800] / 1000
index | fluke 15b | voltmeter | diff | comp | value with avg comp | fluke diff
0 | 0.807 | 0.767 | 0.040 | 0.030 | 0.797 | 0.010 |  | 0 | 1 | 2 | 3 | 4 | 5 | 6 | 7 | 8 | 9 | 10 | 11 | 12 | 13 | 14 | 15 | 16 | 17 | 18 | 19 | 20
1 | 0.825 | 0.786 | 0.039 | 0.030 | 0.816 | 0.009 |  | 30 | 30 | 30 | 30 | 30 | 30 | 30 | 35 | 35 | 30 | 30 | 30 | 30 | 30 | 30 | 30 | 30 | 30 | 30 | 30 | 30
2 | 0.841 | 0.806 | 0.035 | 0.030 | 0.836 | 0.005 |  | 0.830 | 0.840 | 0.850 | 0.860 | 0.870 | 0.880 | 0.890 | 0.905 | 0.915 | 0.920 | 0.930 | 0.940 | 0.950 | 0.960 | 0.970 | 0.980 | 0.990 | 1.000 | 1.010 | 1.020 | 1.030
3 | 0.856 | 0.826 | 0.030 | 0.030 | 0.856 | 0.000
4 | 0.888 | 0.845 | 0.043 | 0.035 | 0.880 | 0.008 |  | 21 | 22 | 23 | 24 | 25 | 26 | 27 | 28 | 29 | 30 | 31 | 32 | 33 | 34 | 35 | 36 | 37 | 38 | 39 | 40 | 41
5 | 0.895 | 0.865 | 0.030 | 0.030 | 0.895 | 0.000 |  | 30 | 30 | 30 | 30 | 30 | 30 | 30 | 30 | 30 | 30 | 30 | 30 | 30 | 30 | 30 | 30 | 30 | 30 | 30 | 30 | 30
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
