marcosbuydid/dc-dc-power-supply/Module_1/Buck-Boost DC:DC Converter.pdf

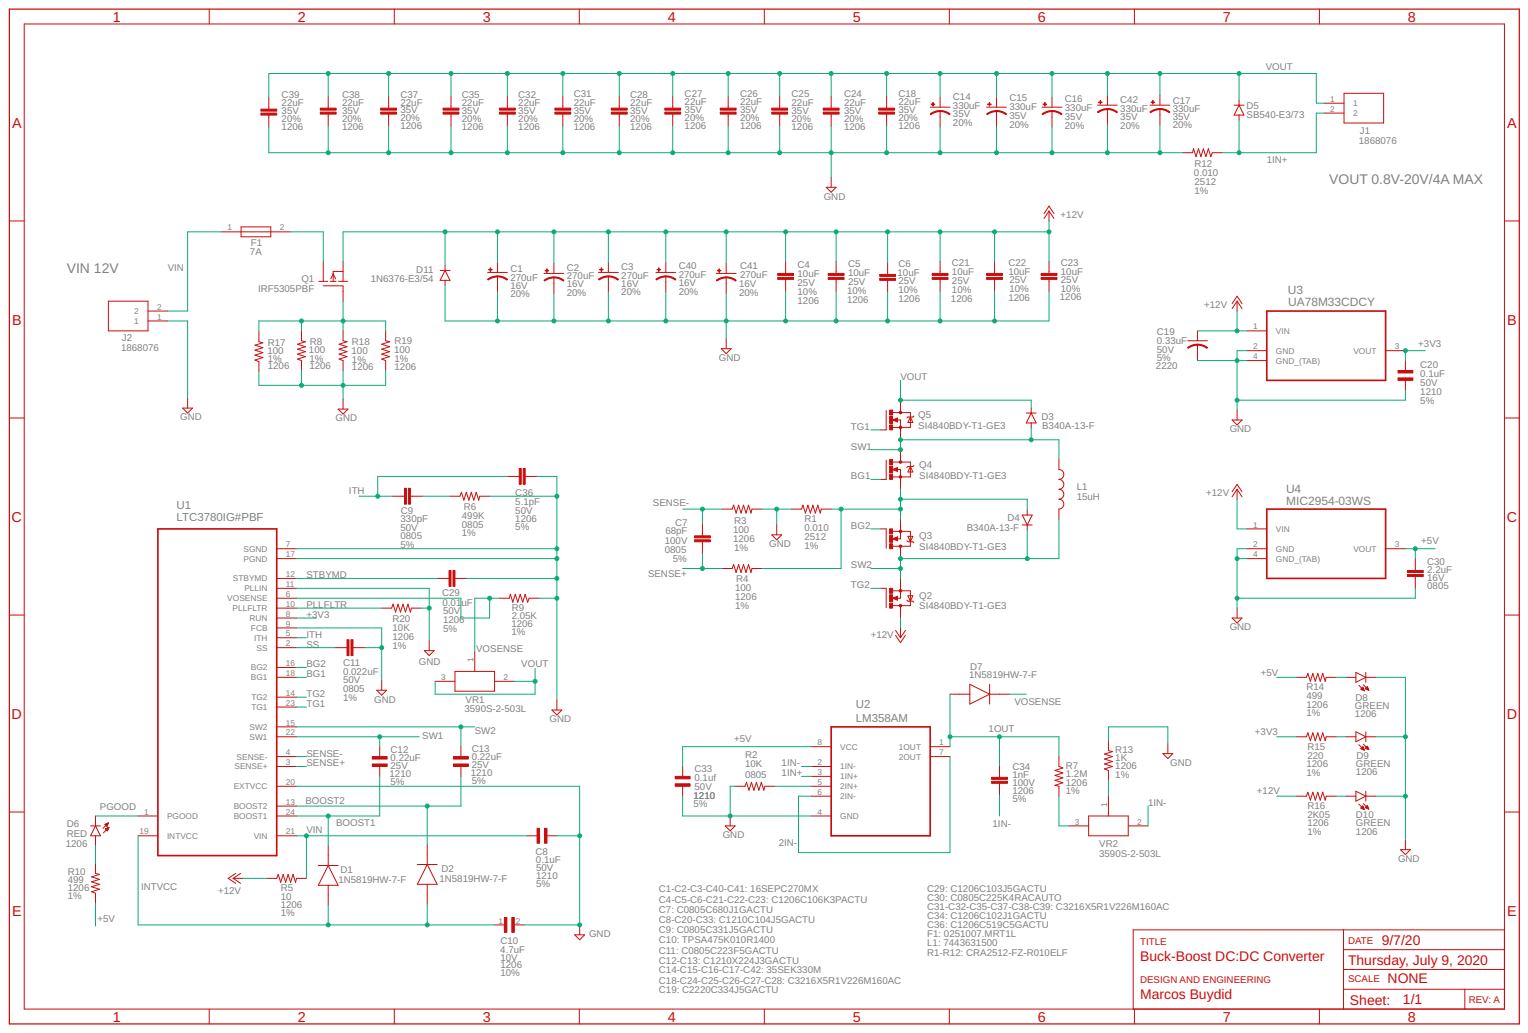
[picture p14: page 1]

13 EXTVCC BOOST2

24 BOOST2

TITLE
Buck-Boost DC:DC Converter
