marcosbuydid/dc-dc-power-supply/Module_2/2 Channel Dual Voltage-Current Meter.pdf

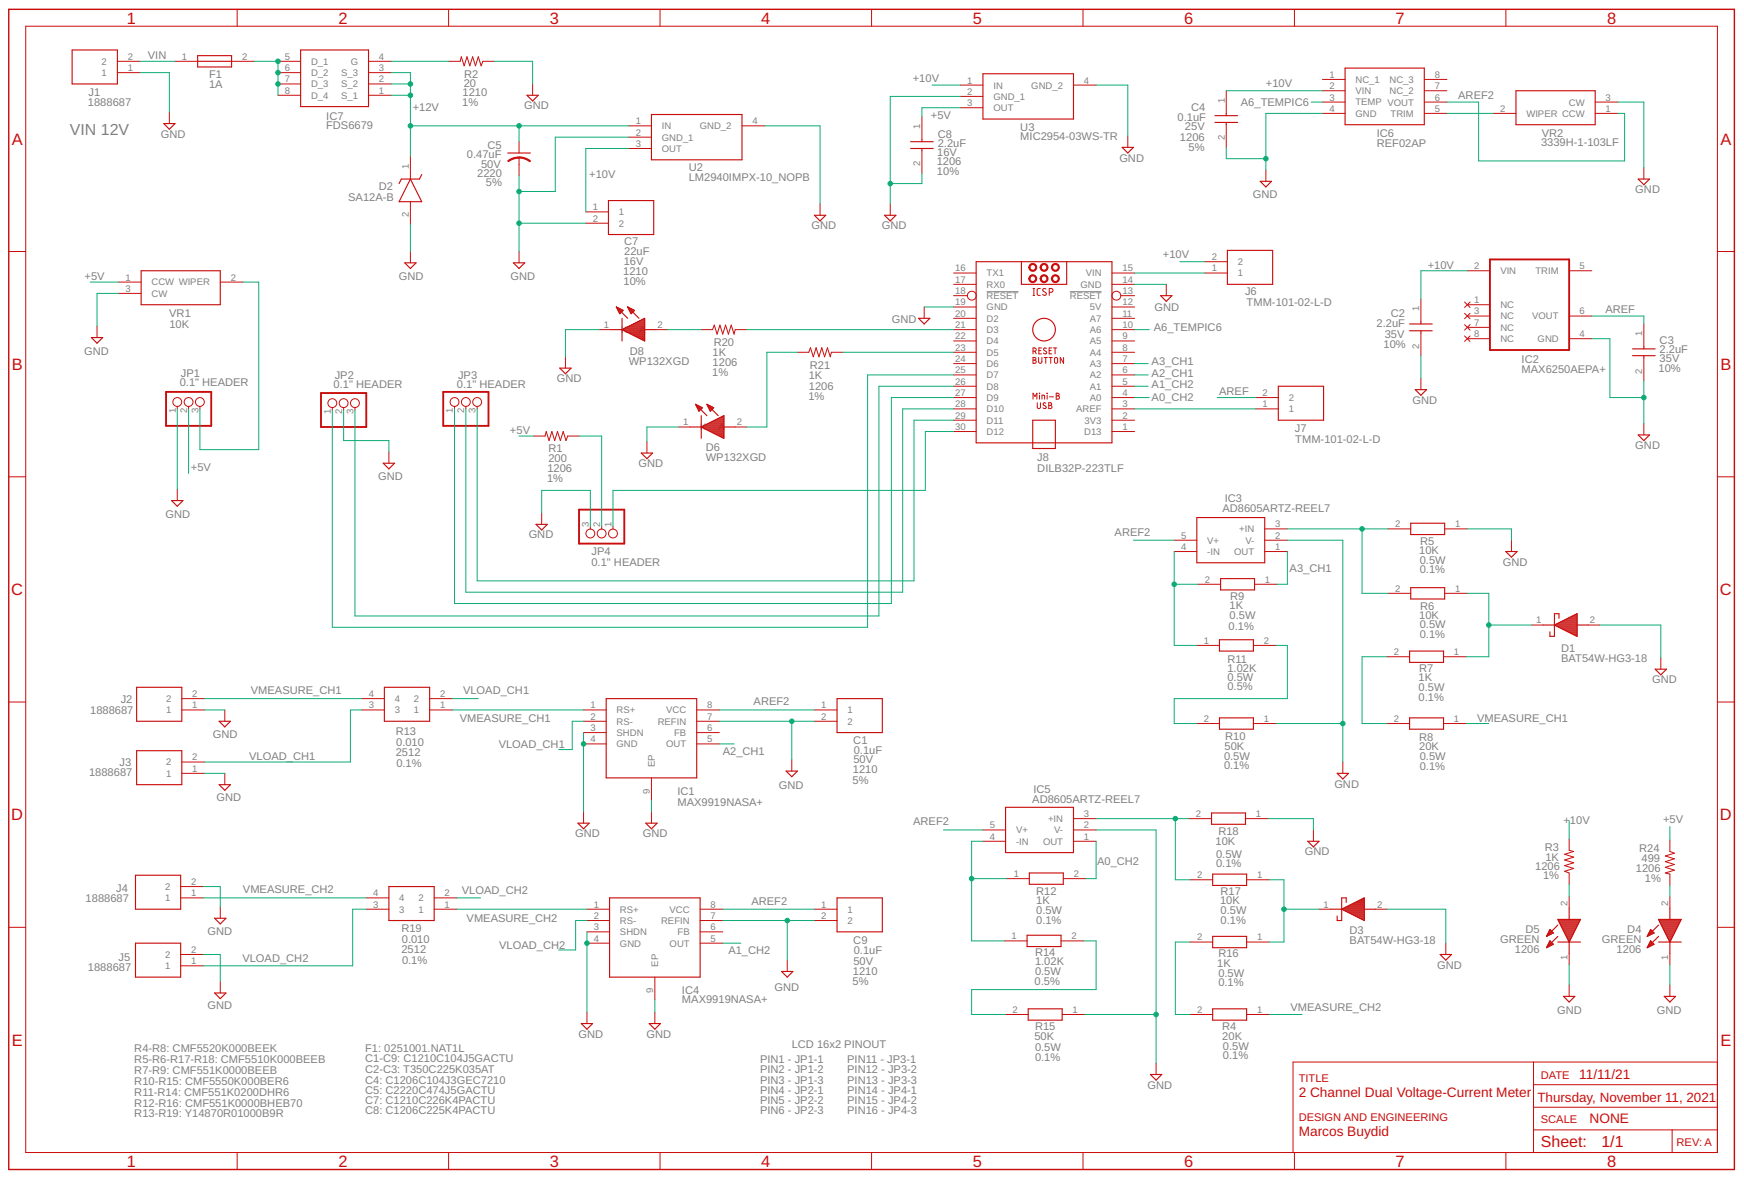
[picture p15: page 1]

TITLE
2 Channel Dual Voltage-Current Meter
