marcosbuydid/dc-dc-power-supply/Module_4/2 Channel Soft-Start.pdf

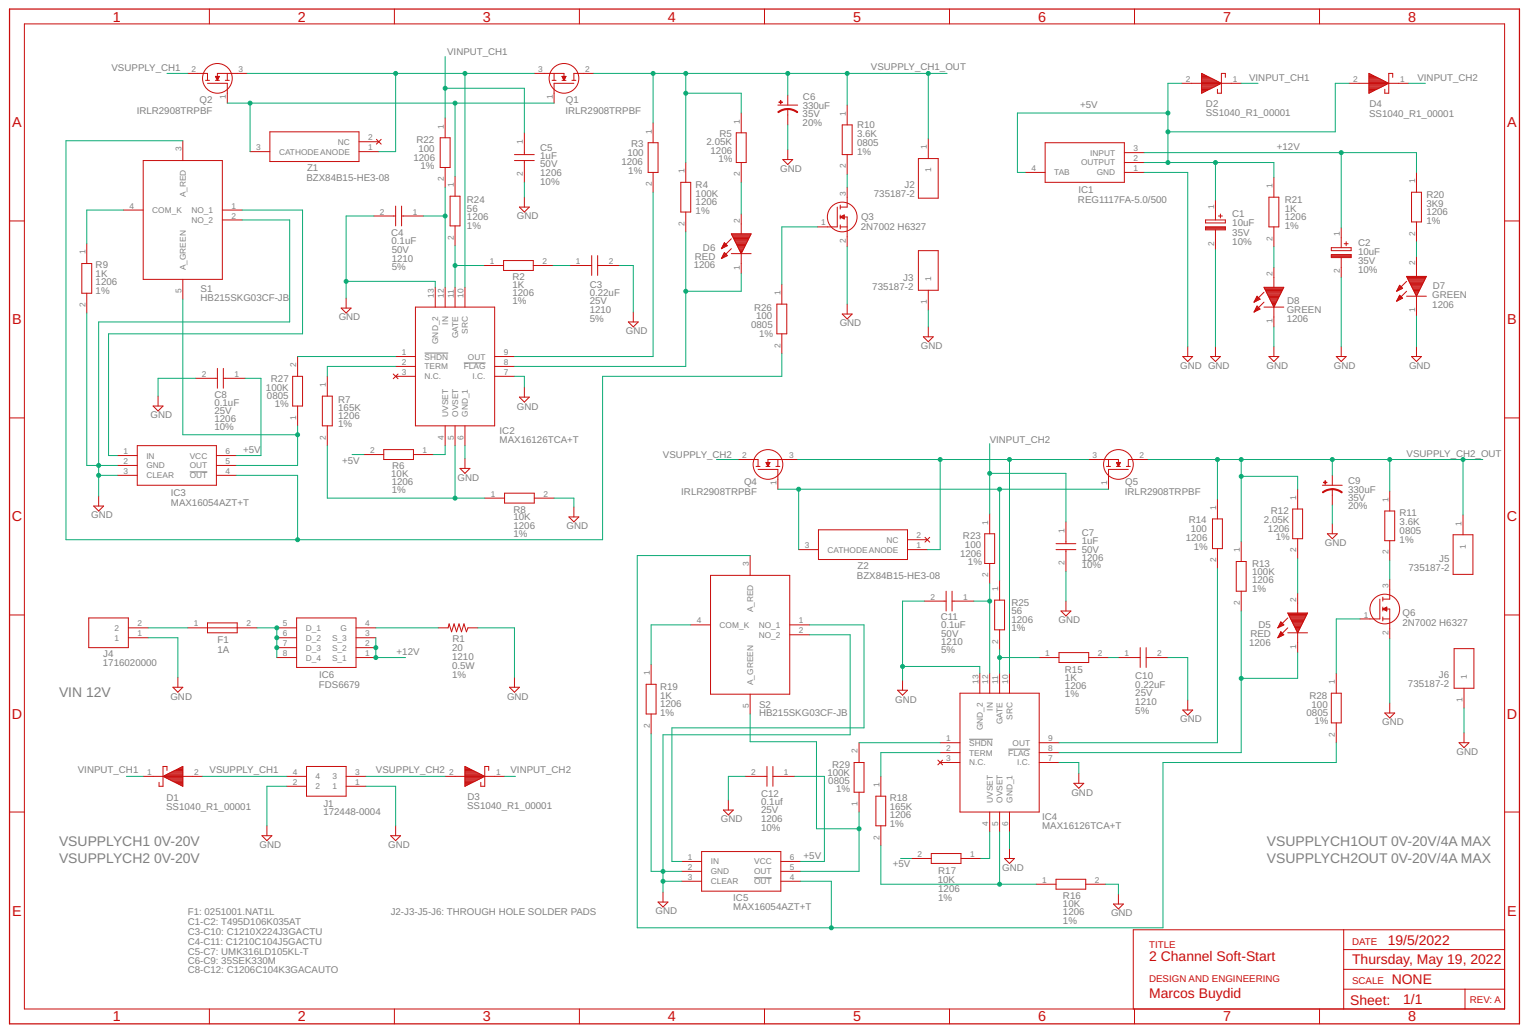
[picture p16: page 1]

J2-J3-J5-J6: THROUGH HOLE SOLDER PADS
