marcosbuydid/dc-dc-power-supply/Module_5/Smart Fan Temperature Controller.pdf

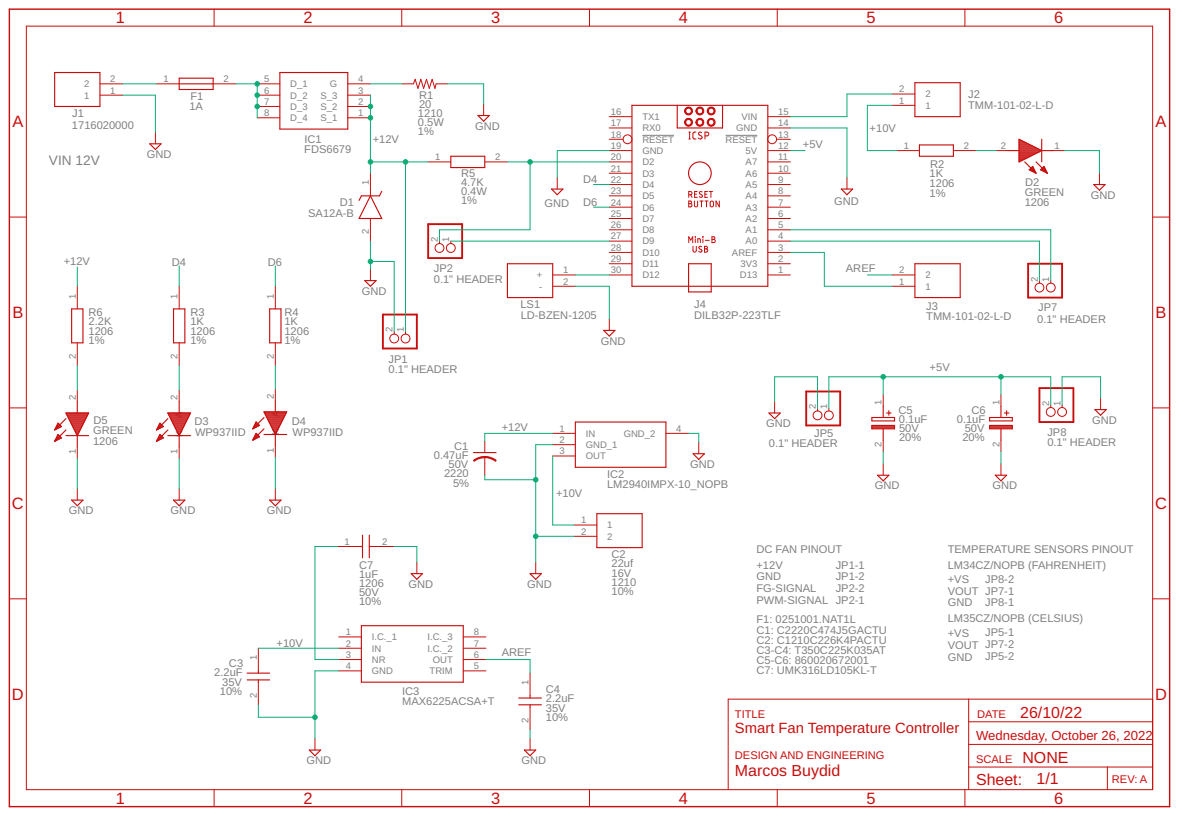
[picture p17: page 1]

TITLE
Smart Fan Temperature Controller
