marcosbuydid/dc-dc-power-supply/Module_6/Dual Mosfet On-Off Switch.pdf

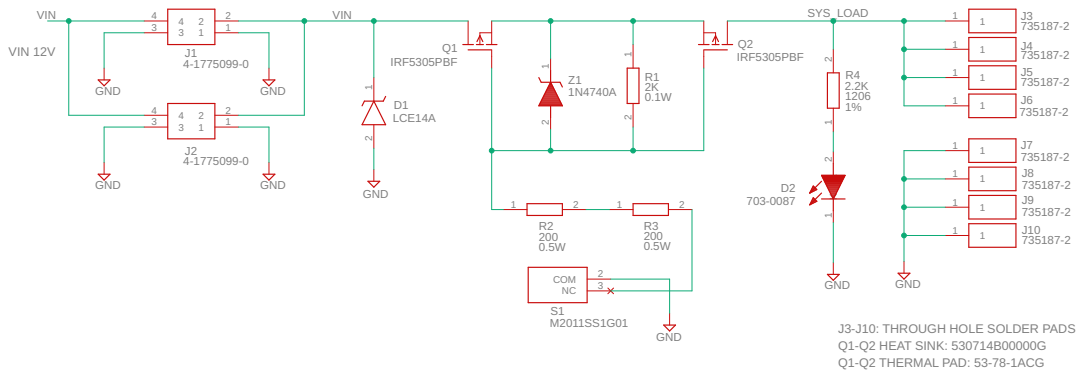
[picture p18: page 1]

J3-J10: THROUGH HOLE SOLDER PADS
Q1-Q2 HEAT SINK: 530714B00000G
Q1-Q2 THERMAL PAD: 53-78-1ACG

TITLE
Dual Mosfet On-Off Switch
