marcosbuydid/dc-dc-power-supply/Module_3/Surge-Stopper-revB.pdf

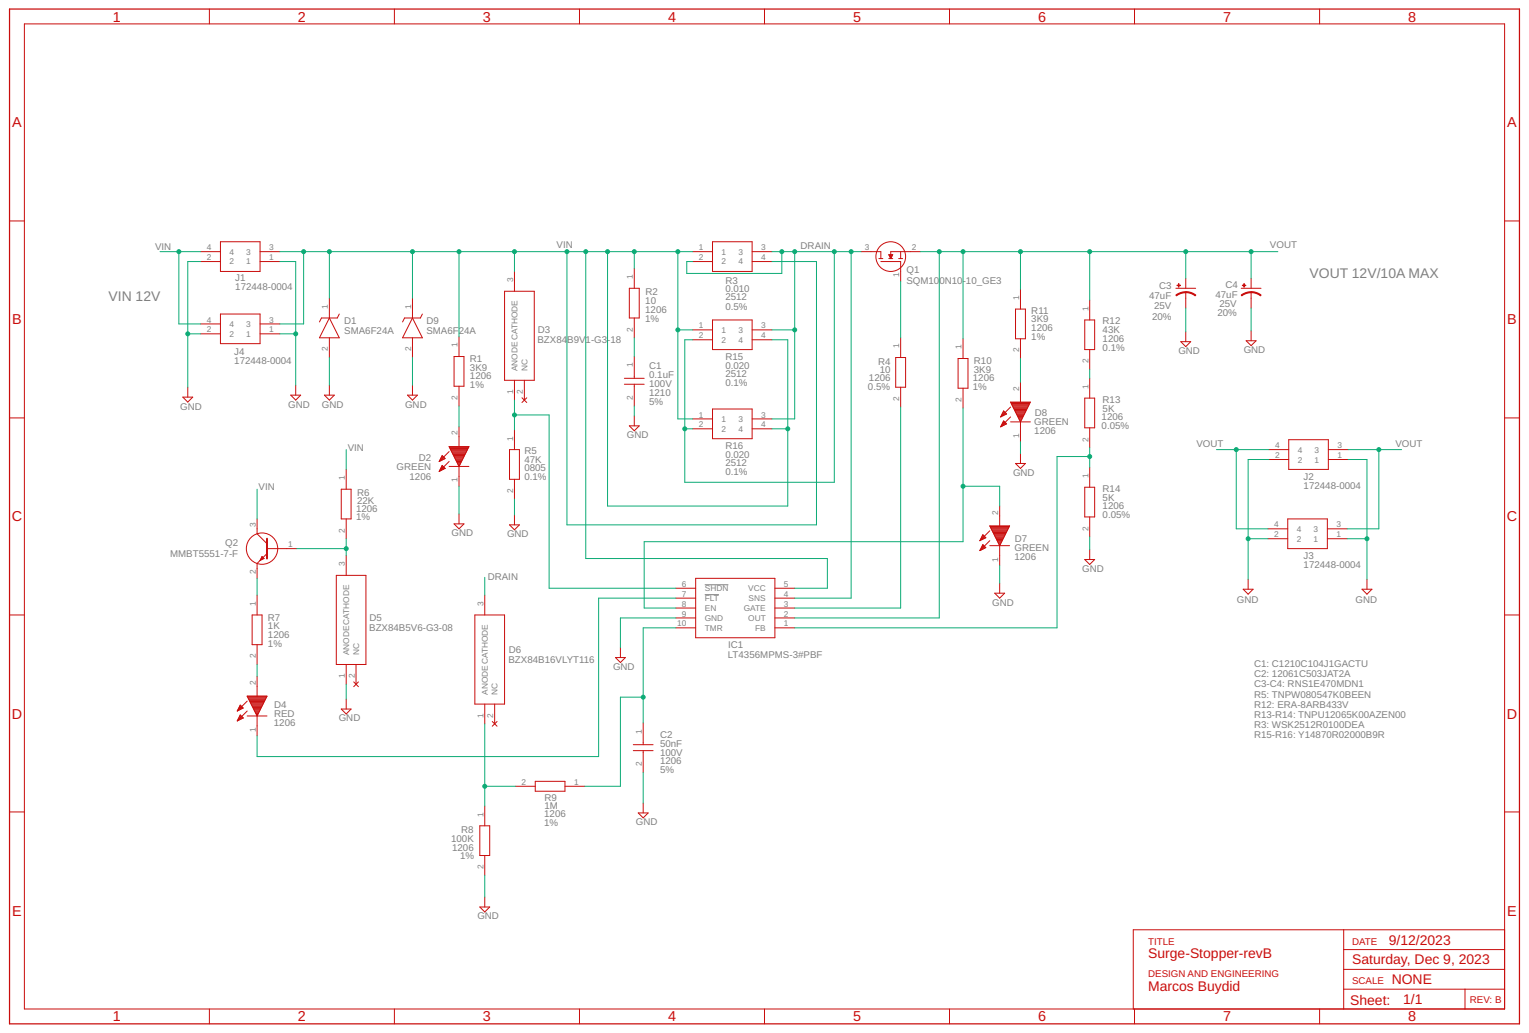
[picture p19: page 1]
