marcosbuydid/dc-dc-power-supply/(commit log)

2023-12-29 add module 5 files
    [fan controller temperature table.xlsx]
2024-02-08 refactor some code in the temperature controller archive
2024-10-06 add module-2 files and update readme
    [current calibration.xlsx, voltmeter-calibration-v3.xlsx]
2026-09-24 rename smart fan temperature controller firmware v2.1 to fw_v0.2.1
